tonioprz/tfg/README.md

# tfg

Trabajo de fin de grado realizado por Antonio Pérez García
