tonioprz/tfg/Documentación/Pinout IRC5C.txt

Pin Nombre
1-8 INPUTS
14-21 OUTPUTS

24  GND 
25  VCC-24V
