tonioprz/tfg/Memoria/0c-notacion/notacion.tex

\chapter*{\notationname}
\pagestyle{especial}
\chaptermark{\notationname}
\phantomsection
\addcontentsline{toc}{listasf}{\notationname}
%\section*{Notación}
%\begin{table}[htbp]
\begin{longtable}{p{3cm}p{8.5cm}}

%$\displaystyle D$ & Tasa de símbolos  (sim/s) \\
%$\displaystyle R_b$ & Tasa binaria (bit/s) \\
%$\displaystyle T$ & Tiempo de símbolo (s) \\
%$\displaystyle T_{b}$ & Tiempo de bit (s) \\
%$W\left( {t} \right)$ & Ruido blanco\\
%$w\left( {t} \right)$ & Función muestra de un ruido blanco\\
%$\displaystyle h_{c}\left( {t} \right)$ & Respuesta impulsiva de un canal LTI continuo en el tiempo\\
%$\displaystyle H_{c}\left( {\omega} \right)$ & Respuesta en frecuencia de un canal LTI continuo en el tiempo\\
%$\displaystyle h_{c}\left( {\tau;t} \right)$ & Respuesta impulsiva de un canal LTV continuo en el tiempo\\
%$\displaystyle H_{c}\left( {\omega;t} \right)$ & Respuesta en frecuencia de un canal LTV continuo en el tiempo\\
%$\displaystyle h_{c}\left( {n} \right)$ & Respuesta impulsiva de un canal LTI discreto en el tiempo\\
%$\displaystyle H_{c}\left( {\Omega} \right)$ & Respuesta en frecuencia de un canal LTI discreto en el tiempo\\
ABB & Asea Brown Boveri \\
CAD & Computer-Aided Design \\
CC & Corriente Continua \\
E/S & Entrada/Salida \\
EEPROM & Electrically Erasable Programmable Read-Only Memory\\
ETSI & Escuela Técnica Superior de Ingeniería \\
g & Gramo \\
GND & Tierra \\
GPIO & General-Purpouse Input/Output. Pines de uso general \\
I2C & Inter-Integrated Circuit \\
ICSP & In-circuit Serial Programming \\
IP & Internet Protocol \\
kB & Kilobyte \\
k$\Omega$ & Kiloohmio \\
LCD & Liquid-Crystal Display. Pantalla de cristal líquido \\
LED & Light-Emitting Diode \\
mA & Miliamperio \\
MHz & Megahercios \\
mm & Milímetros \\
PWM & Modulación por ancho de pulso \\
SPI & Serial Peripheral Interface \\
SRAM & Static Random-Access Memory \\
TCP & Transmission Control Protocol \\
TTL & Transistor-Transistor Logic\\
TWI & Two-Wire Interface \\
UART & Universal Asynchronous Receiver-Transmitter \\
USB & Universal Serial Bus \\
V & Voltio \\

\end{longtable}
\newpage
%\end{table}
%

%\phantomsection
%\addcontentsline{toc}{listasf}{Acrónimos}
%\section*{Acrónimos}
%\begin{table}[htbp]
%\begin{tabular}{p{2cm}p{10cm}}
%Escuela Técnica Superior de In
%LTI & Lineal Invariante con el Tiempo \\
%LTV& Lineal Variable con el Tiempo\\
%AWGN& Ruido blanco gaussiano aditivo\\
%DMS& Fuente discreta sin memoria\\
%AEP& Propiedad de equipartición asintótica\\
%WLLN& Ley Débil de los Grandes Números\\
%DMC& Canal Discreto sin Memoria\\
%BSC& Canal Simétrico Binario\\
%BEC& Canal Binario con Borrado\\
%\end{tabular}
%\end{table}

%\nota{El libro de Lapidoth tiene una excelente recopilación.}
