tonioprz/tfg/Memoria/0a-agradecimientos/agradecimientos.tex

% !TEX root =../LibroTipoETSI.tex
\chapter*{Agradecimientos}
%\pagestyle{especial}
\pagestyle{empty}
%\chaptermark{Agradecimientos}
\phantomsection
%\addcontentsline{toc}{listasf}{Agradecimientos}
%\vspace{1cm}
%{\huge{Agradecimientos}}
%\vspace{1cm}

\lettrine[lraise=-0.1, lines=2, loversize=0.25]{E}{l} trabajo de fin de grado
es la culminación de mucho esfuerzo realizado durante años de mis padres Antonio
y Rosario. Agradezco su paciencia y apoyo durante todo este tiempo.

{\flushleft{\hfill \emph{Antonio Pérez García}}}%
\vspace{-.3cm}
%{\flushleft{\hfill \emph{Subdirección de Comunicaciones y Recursos Comunes}}}%
{\flushleft{\hfill \emph{Sevilla, 2022}}}%
