tonioprz/tfg/Memoria/10-anexos/anexo.tex

\chapter*{Anexo II: Esquemáticos de placas electrónicas}
\pagestyle{especial}
\chaptermark{Anexo II: Esquemáticos de placas electrónicas}
\phantomsection
\addcontentsline{toc}{listasf}{Anexo II: Esquemáticos de placas electrónicas}

En este anexo se adjuntan los planos esquemáticos de las placas electrónicas
