tonioprz/tfg/Memoria/09-guiadeuso/HMI_REAL.pdf

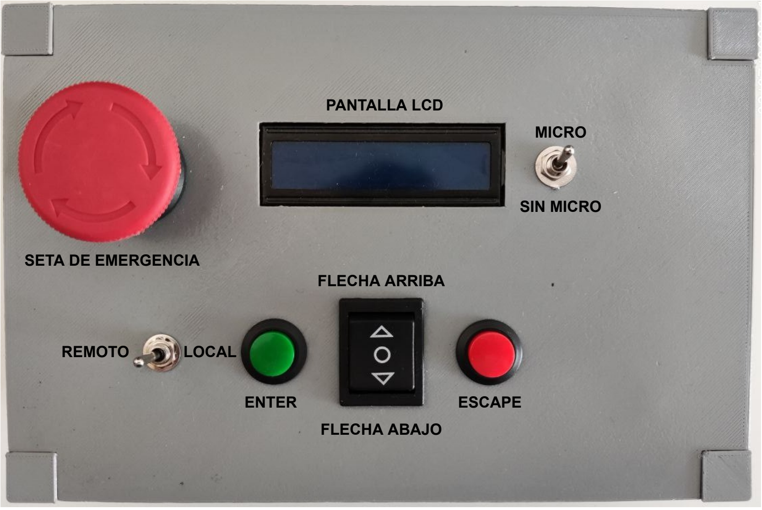
[picture p31: page 1]

MICRO

SIN MICRO

REMOTO | LOCAL
ENTER | ESCAPE
FLECHA ABAJO

FLECHA ARRIBA

PANTALLA LCD

SETA DE EMERGENCIA
