tonioprz/tfg/Documentación/HMI.jpg

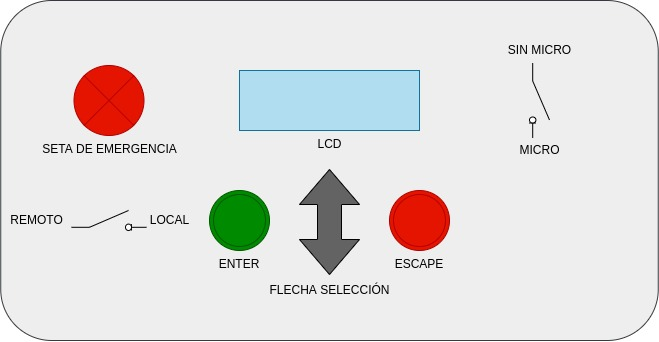
Documentación/HMI.jpg
