tonioprz/tfg/Documentación/Meme.jpg

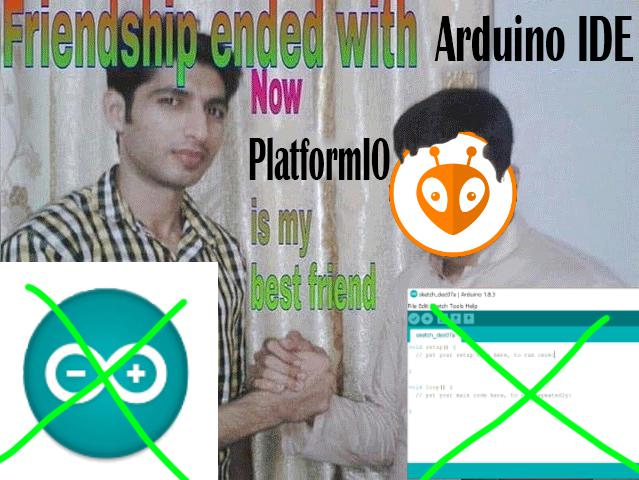
Documentación/Meme.jpg
