tonioprz/tfg/Documentación/output/salida.pdf_dir/0_salida.pdf.jpg

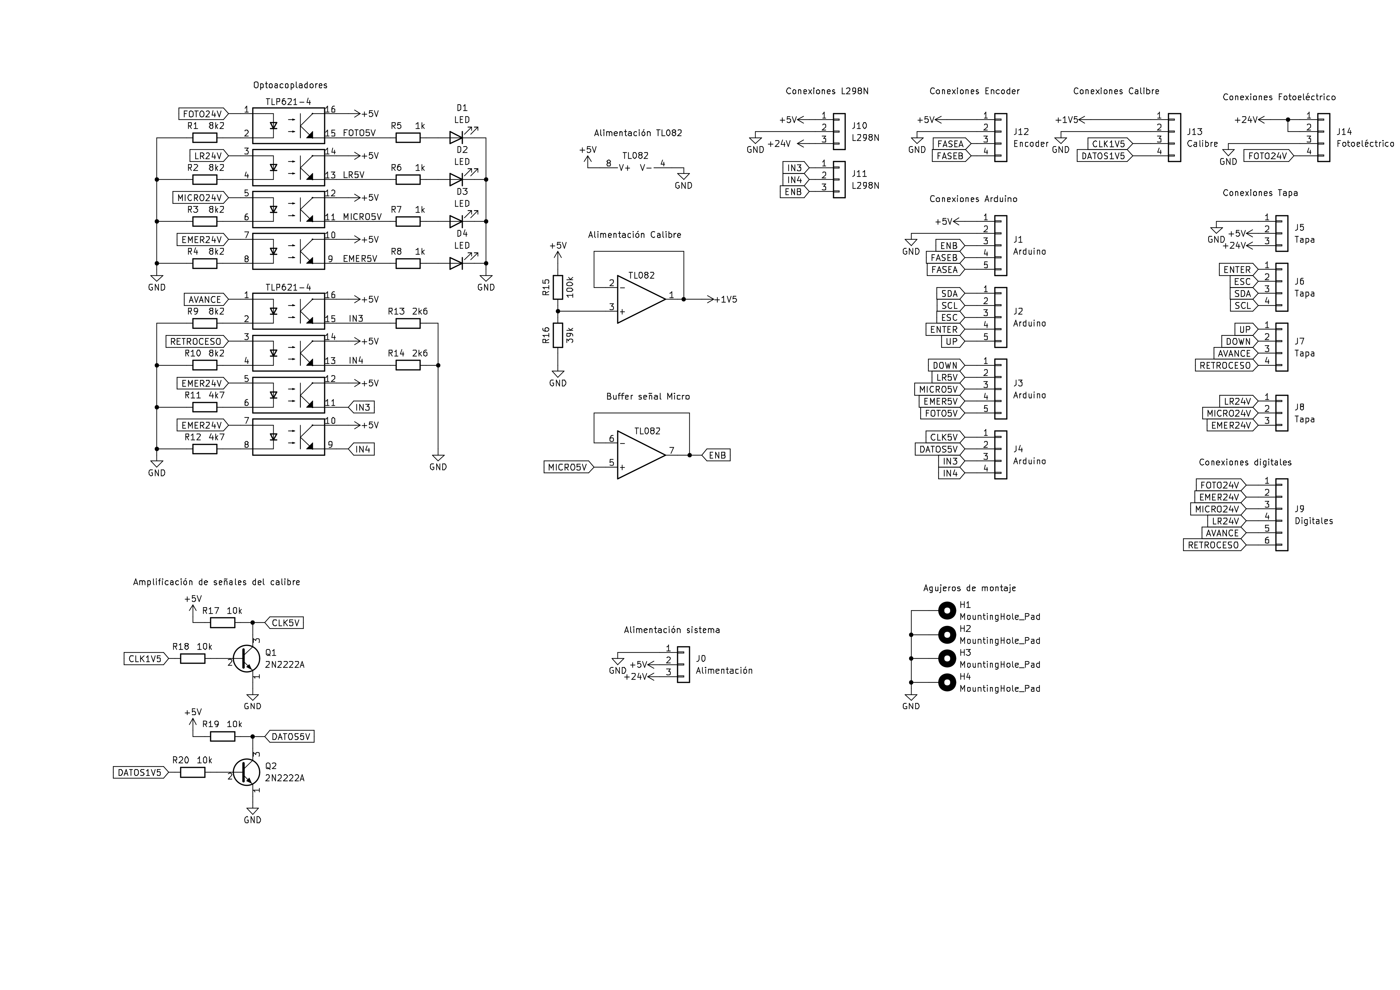
Documentación/output/salida.pdf_dir/0_salida.pdf.jpg
