tonioprz/tfg/Documentación/planotapa.jpg

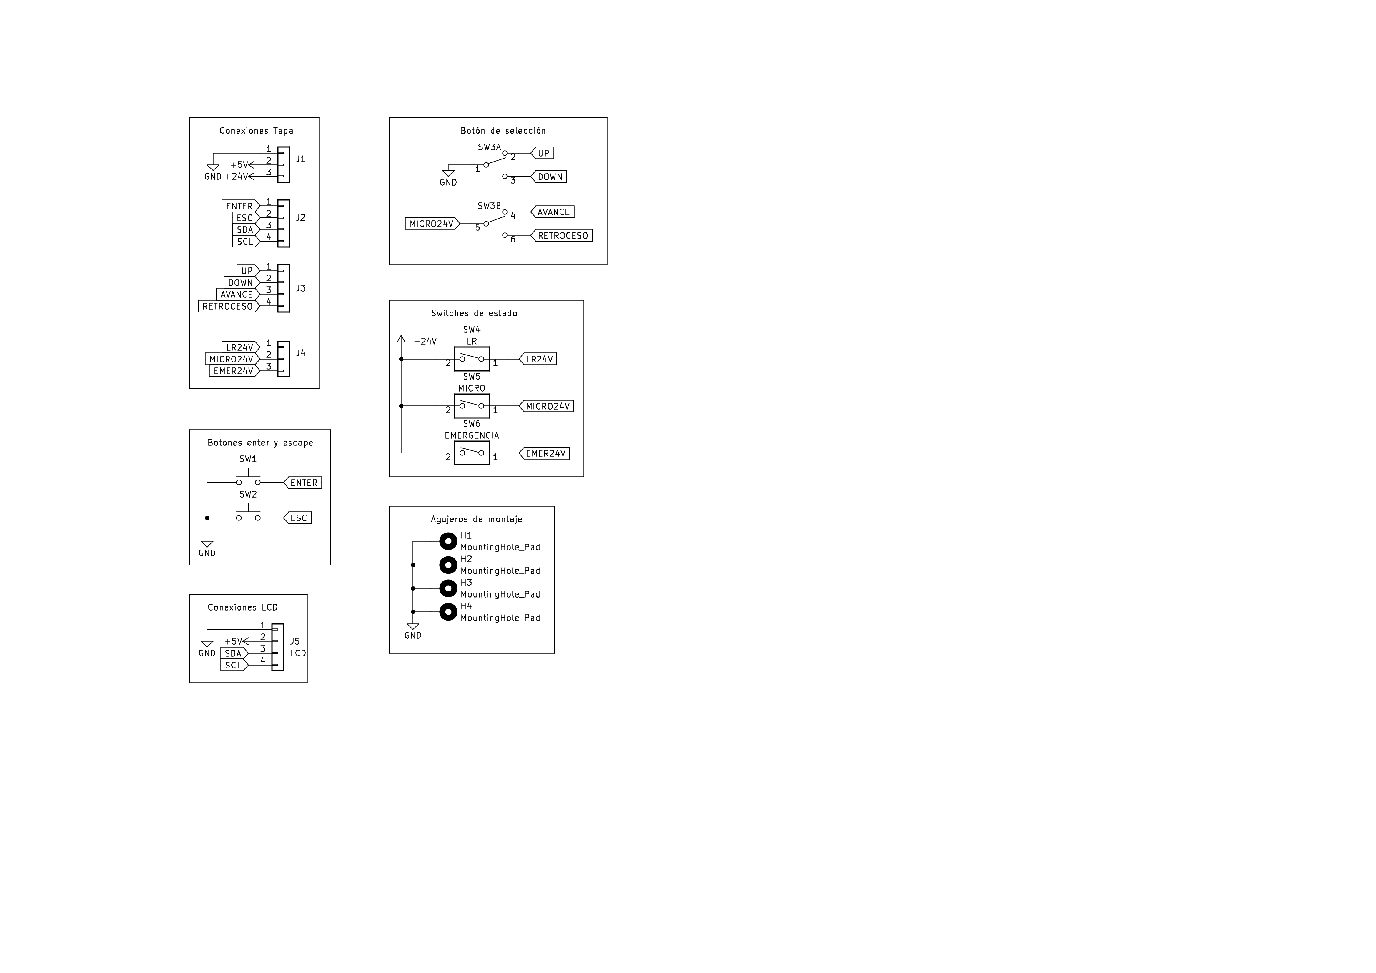
Documentación/planotapa.jpg
