tonioprz/tfg/Memoria/02-hardware/11-optoac.png

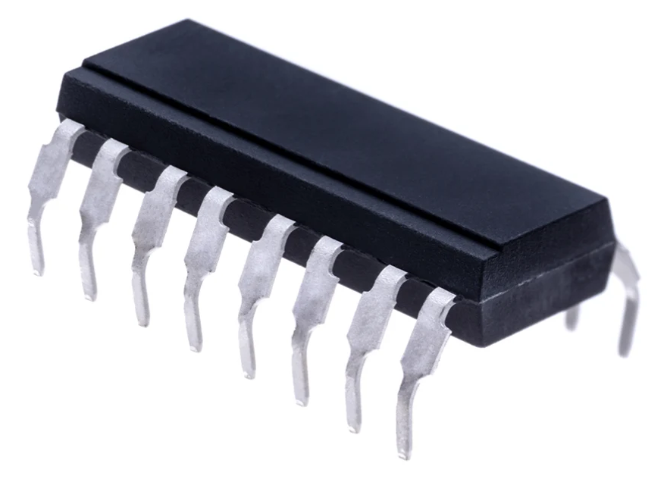
Memoria/02-hardware/11-optoac.png
