tonioprz/tfg/Memoria/09-guiadeuso/paneldecontrol.jpg

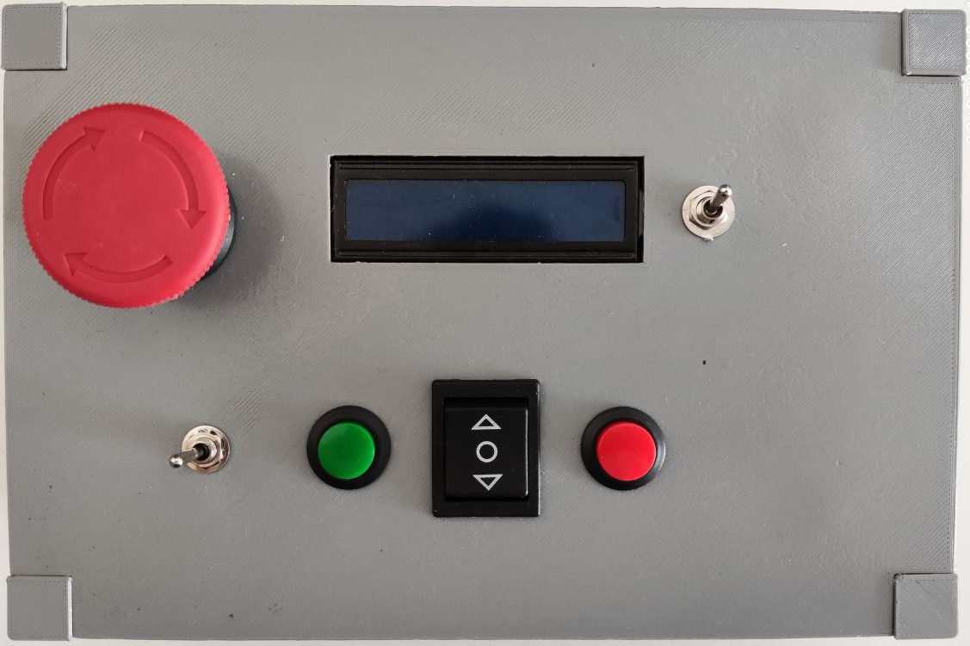
Memoria/09-guiadeuso/paneldecontrol.jpg
