tonioprz/tfg/Memoria/09-guiadeuso/wobj1.png

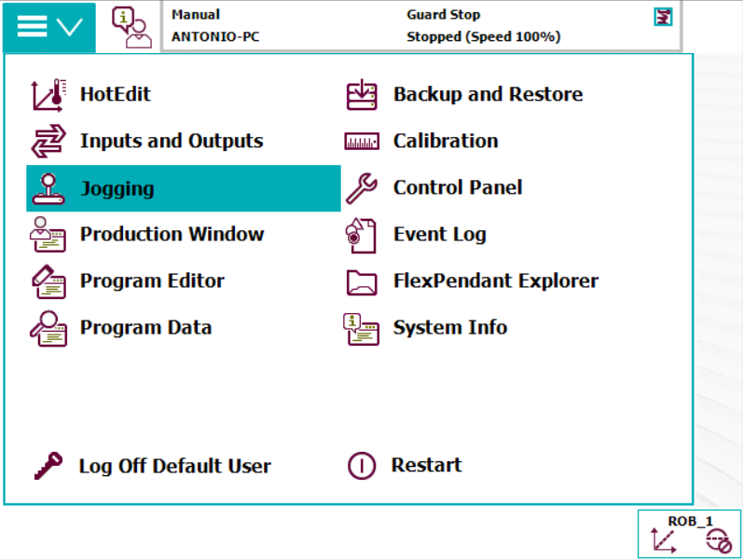
Memoria/09-guiadeuso/wobj1.png
