tonioprz/tfg/Memoria/09-guiadeuso/wobj2.png

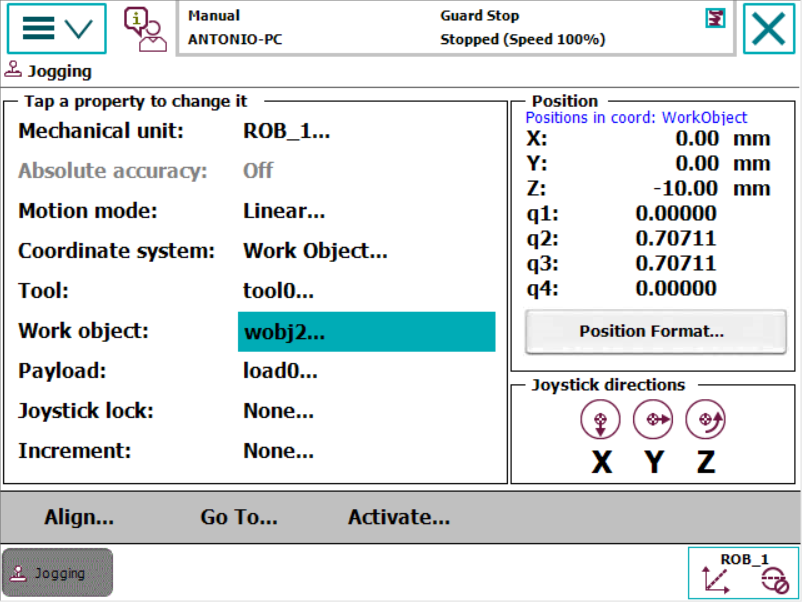
Memoria/09-guiadeuso/wobj2.png
