tonioprz/tfg/Memoria/09-guiadeuso/wobj3.png

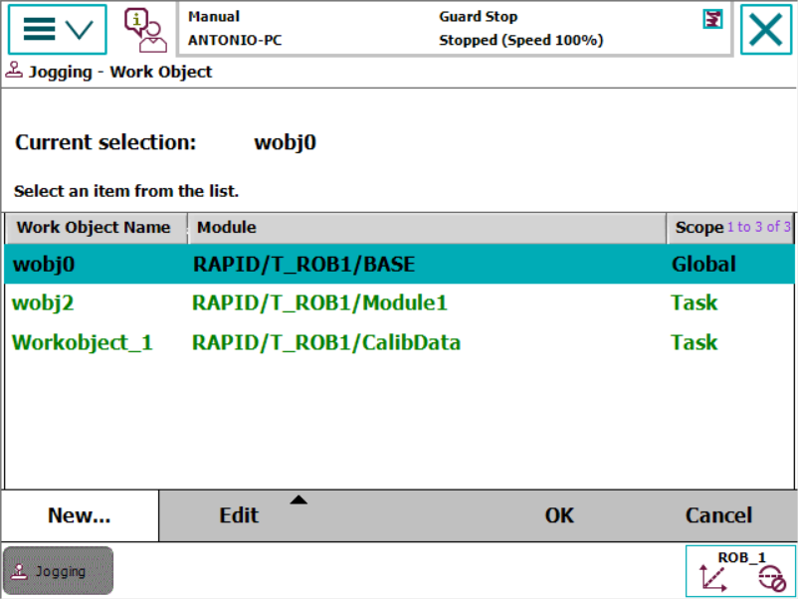
Memoria/09-guiadeuso/wobj3.png
