tonioprz/tfg/Memoria/04-caja/ensamblajetapaplanta.png

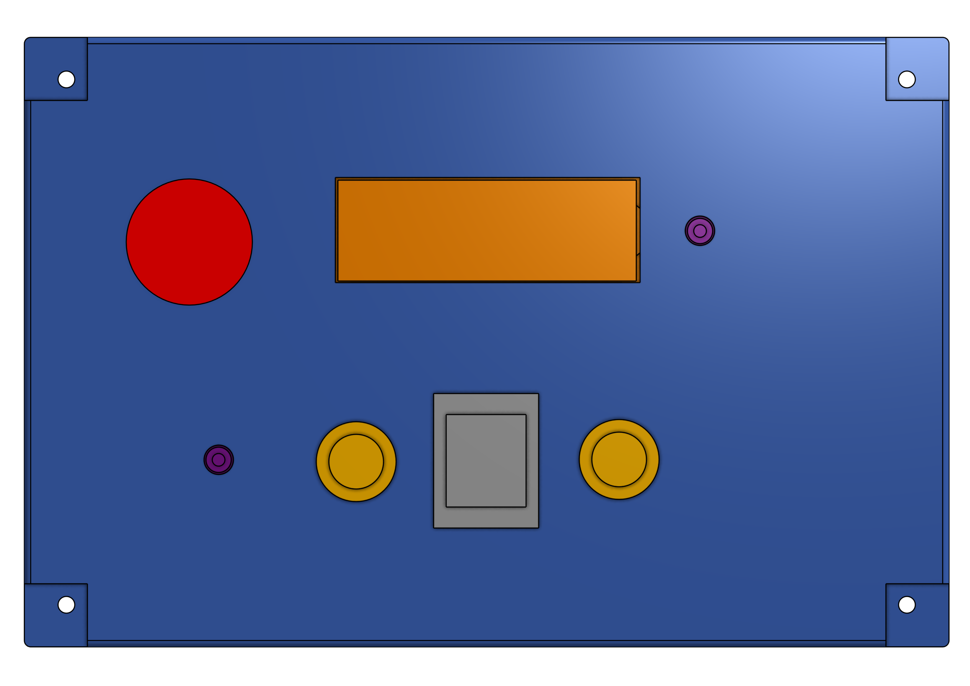
Memoria/04-caja/ensamblajetapaplanta.png
