tonioprz/tfg/Memoria/07-resultados/modoemer.jpg

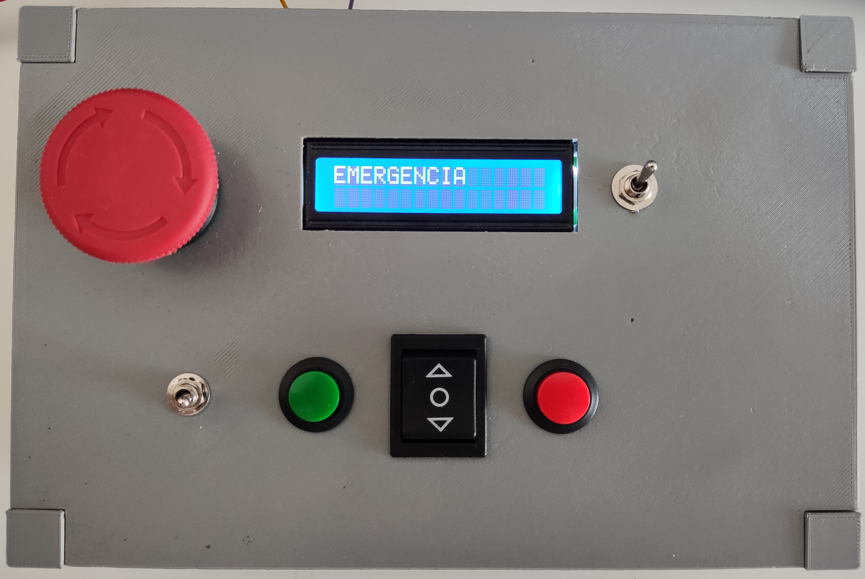
Memoria/07-resultados/modoemer.jpg
