tonioprz/tfg/Memoria/07-resultados/modolocal.jpg

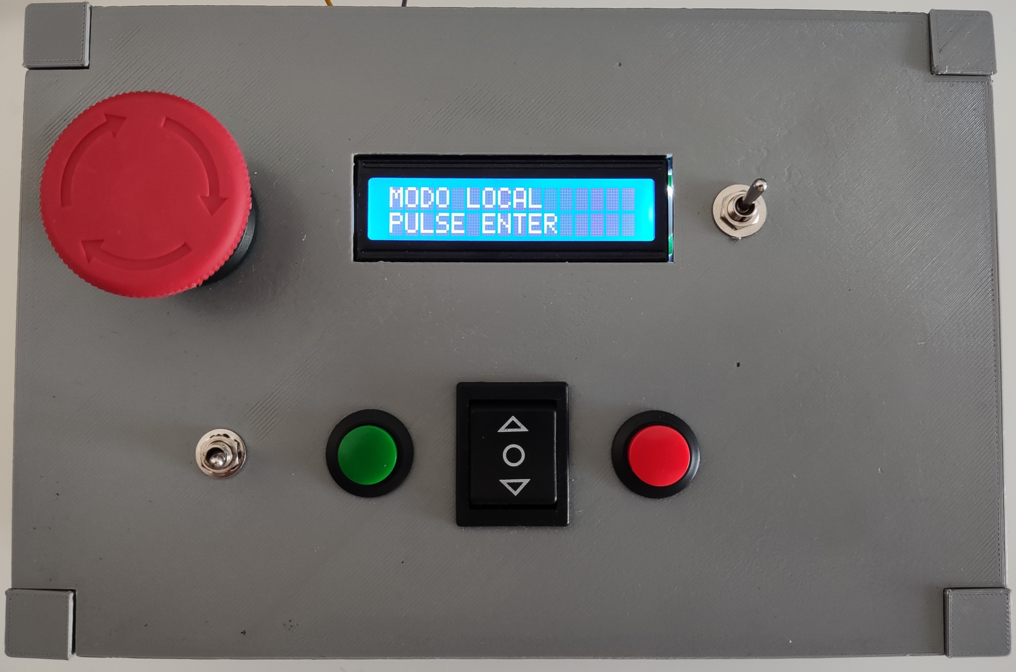
Memoria/07-resultados/modolocal.jpg
