tonioprz/tfg/Memoria/07-resultados/modoremoto.jpg

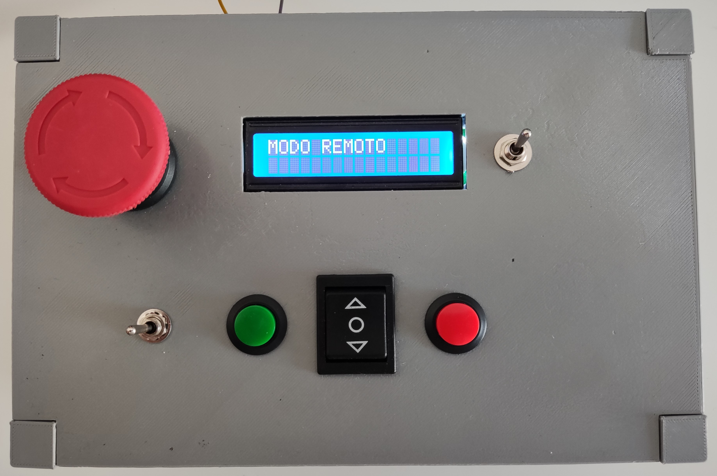
Memoria/07-resultados/modoremoto.jpg
