tonioprz/tfg/Memoria/07-resultados/modosinmicro.jpg

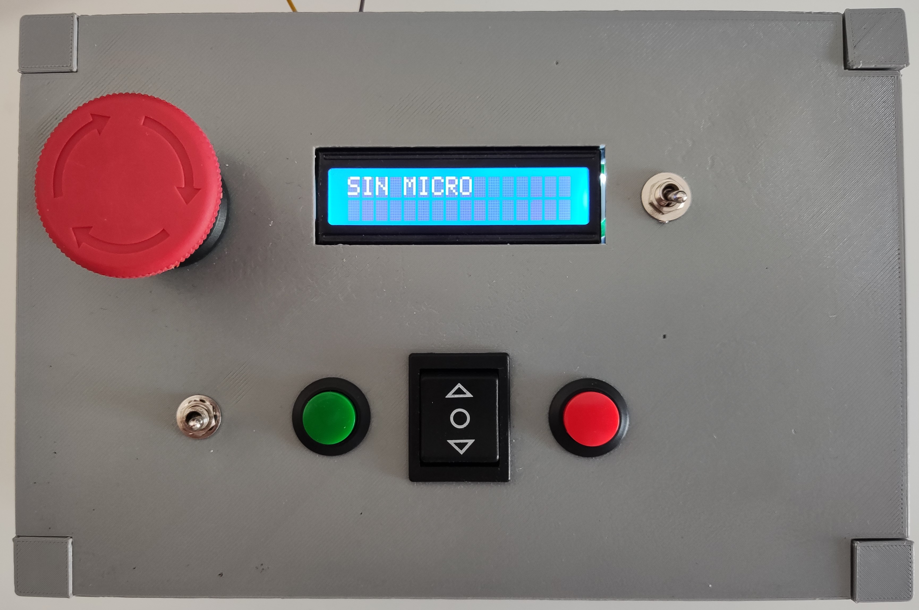
Memoria/07-resultados/modosinmicro.jpg
