tonioprz/tfg/Documentación/CAJA1.pdf

Modos de funcionamiento:

1 | 2 | 3
LOCAL | CON MICRO | CONFIGURACION | AVANCE POS. ABSOLUTA

AVANCE DISCRETO

EJECUCION | AVANCE POS. ABSOLUTA
| AVANCE DISCRETO
SIN MICRO | | Avance/retroceso con pulsador
REMOTO | CON MICRO | CONFIGURACION | AVANCE POS. ABSOLUTA

AVANCE DISCRETO

EJECUCION | AVANCE POS. ABSOLUTA
| AVANCE DISCRETO
SIN MICRO | Avance/retroceso señales digitales de 24V
CON MICRO | ETHERNET: PosX, PosY Sensor fotoeléctrico Estados de cinta Actuación remota | ETHERNET: PosX, PosY Sensor fotoeléctrico Estados de cinta Actuación local
SIN MICRO | Salidas digitales al robot: SD: Sensor fotoeléctrico Actuación remota desde robot ED: Avance cinta ED: Retroceso cinta | Manual sin conexión SD: Sensor fotoeléctrico Actuación local Pulsador avance cinta Pulsador retroceso cinta
REMOTO | LOCAL

LOCAL-CON MICRO:

Actuación local: Ordenes de posicionado por parte del usuario (introducción de datos y pulsar ejecución de movimiento)

El micro lee las posiciones y sensor fotoeléctrico y lo transmite por Ethernet al robot, enviando estados del posicionador (ejecutando orden, fin de orden, emergencia, etc).

LOCAL-SIN MICRO:

Actuación local: movimiento manual del motor de la cinta con los pulsadores de avance/retroceso (usuario)

El micro está fuera de servicio, el robot no comunicado.

El robot solo recibe SEÑALES DIGITALES de sensor fotoeléctrico

REMOTO-CON MICRO:

Actuación remota: Ordenes de posicionado por parte del robot (introducción de datos y ordenes de ejecución de movimientos) a través de Ethernet

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

REMOTO-SIN MICRO:

Actuación remota: movimiento del motor de la cinta con SEÑALES DIGITALES avance/retroceso por parte del robot.

El robot recibe SEÑALES DIGITALES de sensor fotoeléctrico

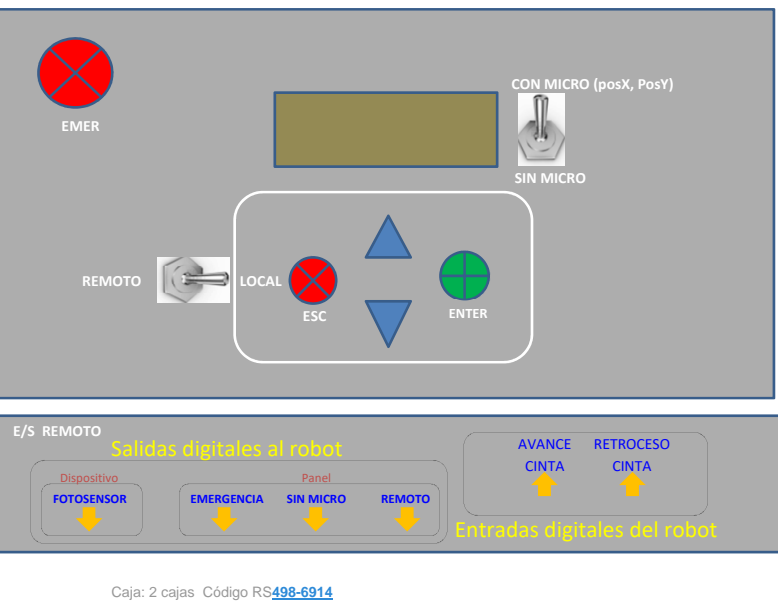
[picture p52: page 3]
ESC; ENTER; FOTOSENSOR; EMERGENCIA; EMER; SIN MICRO; AVANCE CINTA; LOCAL; E/S REMOTO; REMOTO; RETROCESO CINTA; Dispositivo; Panel

CON MICRO (posX, PosY)

Salidas digitales al robot

Entradas digitales del robot

Caja: 2 cajas Código RS498-6914

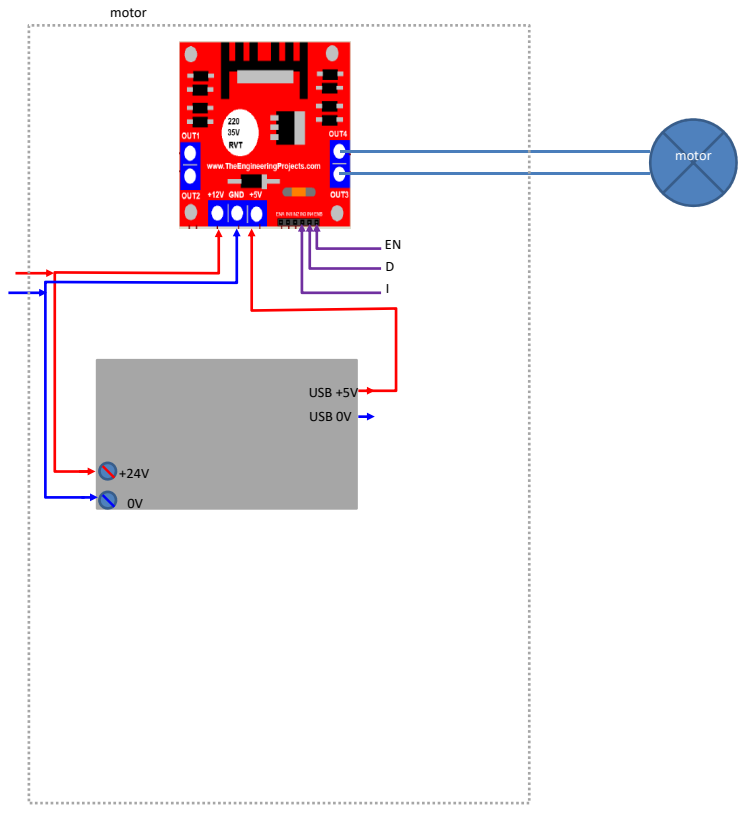
[picture p53: page 4]
motor; USB +5V; USB 0V

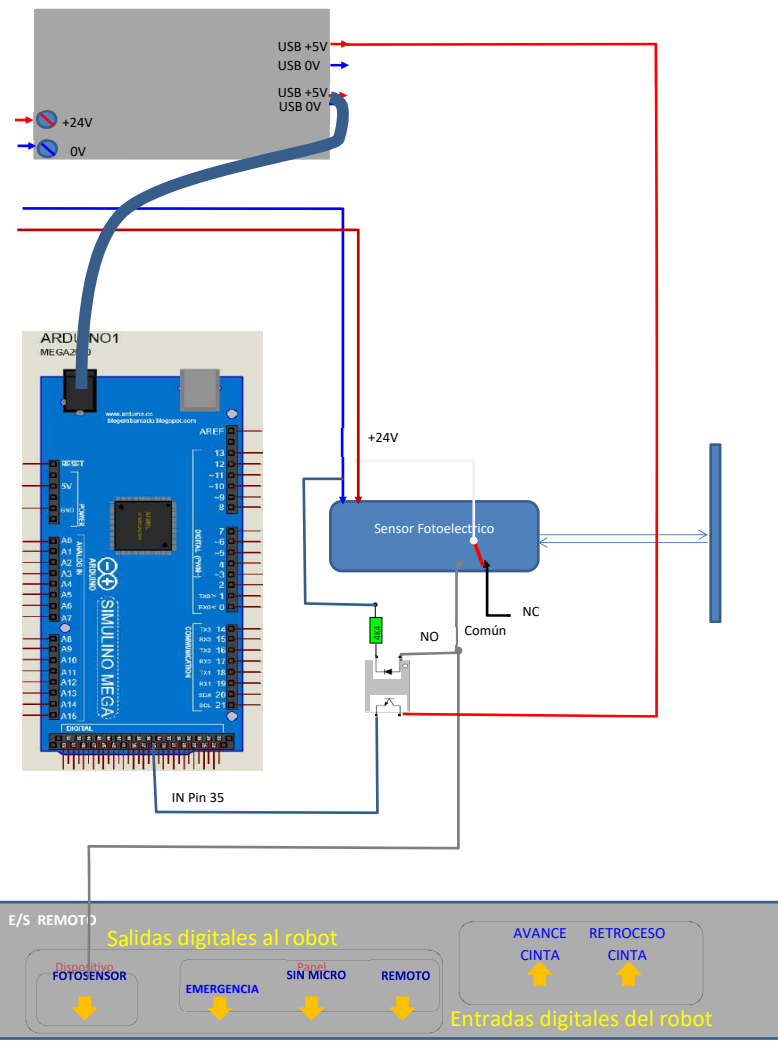
[picture p54: page 5]
Sensor Fotoelectrico; Común; FOTOSENSOR; SIN MICRO; REMOTO; EMERGENCIA; AVANCE CINTA; E/S REMOTO; RETROCESO CINTA; Dispositivo; Panel; USB +5V USB 0V; IN Pin 35

Salidas digitales al robot

Entradas digitales del robot

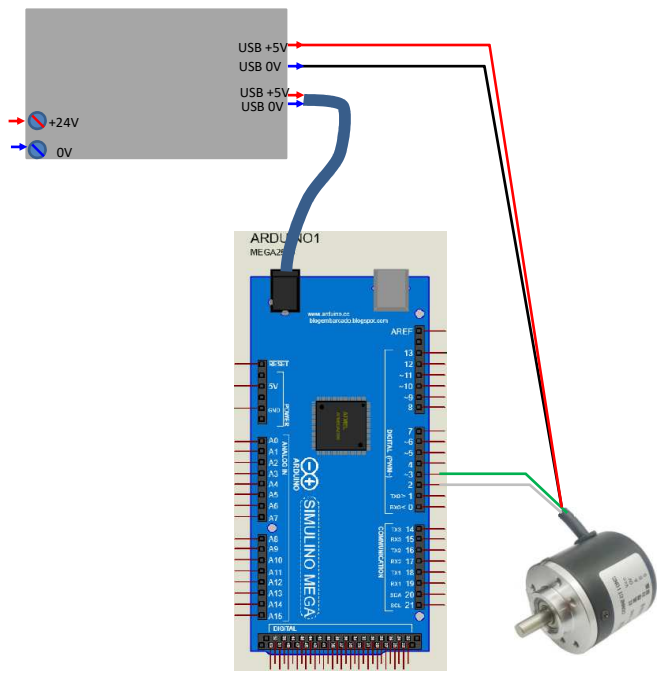
[picture p55: page 6]
USB; USB 0

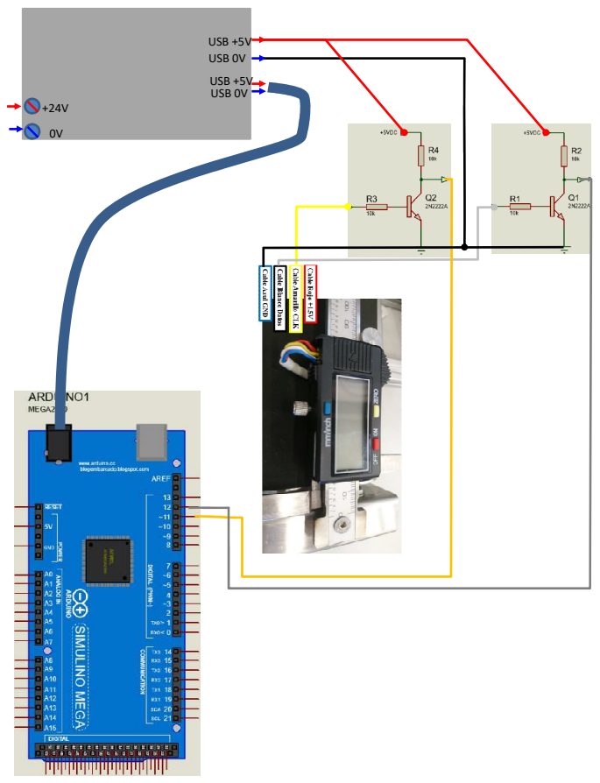
[picture p56: page 7]
USB; USB 0

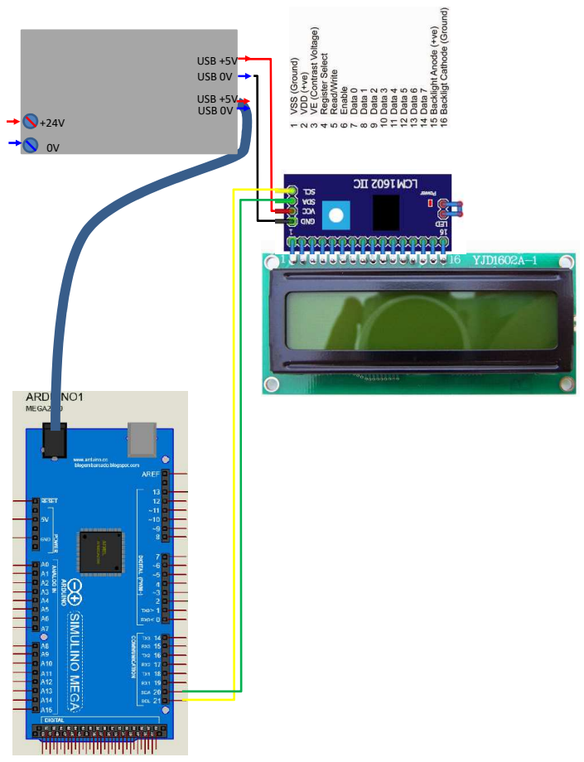
[picture p57: page 8]
USB; USB 0

## Salidas digitales al robot

## Entradas digitales del robot

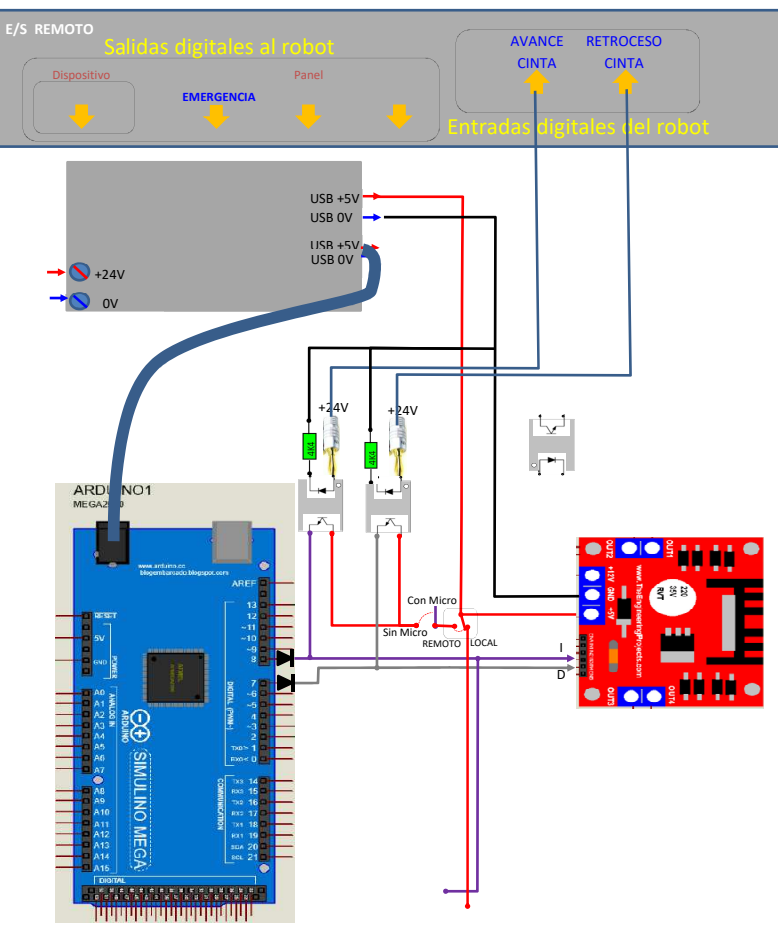
[picture p58: page 9]
EMERGENCIA; AVANCE CINTA; E/S REMOTO; RETROCESO CINTA; Dispositivo; Panel; USB +5V USB 0V; REMOTO LOCAL; Con Micro; Sin Micro
