tonioprz/tfg/Memoria/09-guiadeuso/DIGITALES_REAL.pdf

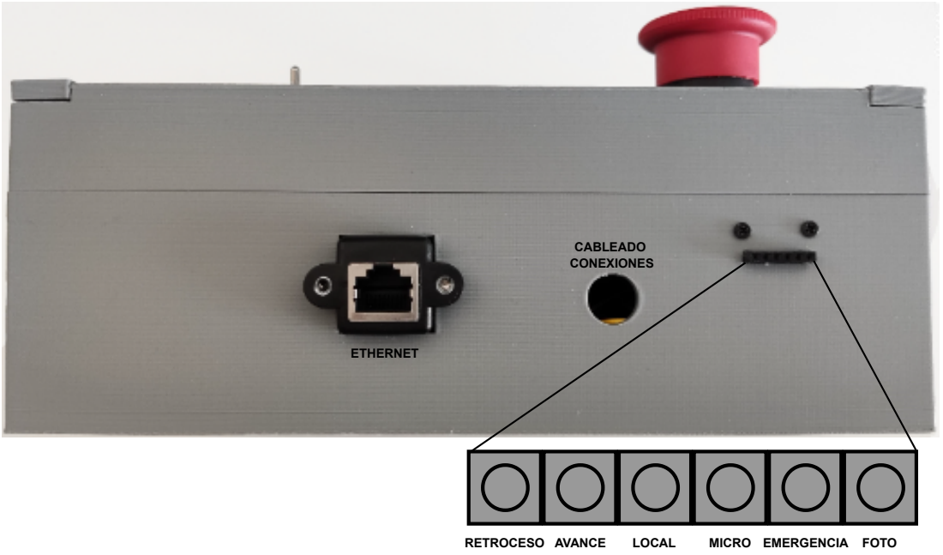
[picture p59: page 1]
RETROCESO AVANCE; LOCAL; MICRO EMERGENCIA FOTO; ETHERNET; CABLEADO CONEXIONES
