tonioprz/tfg/Memoria/planos/tapa.pdf

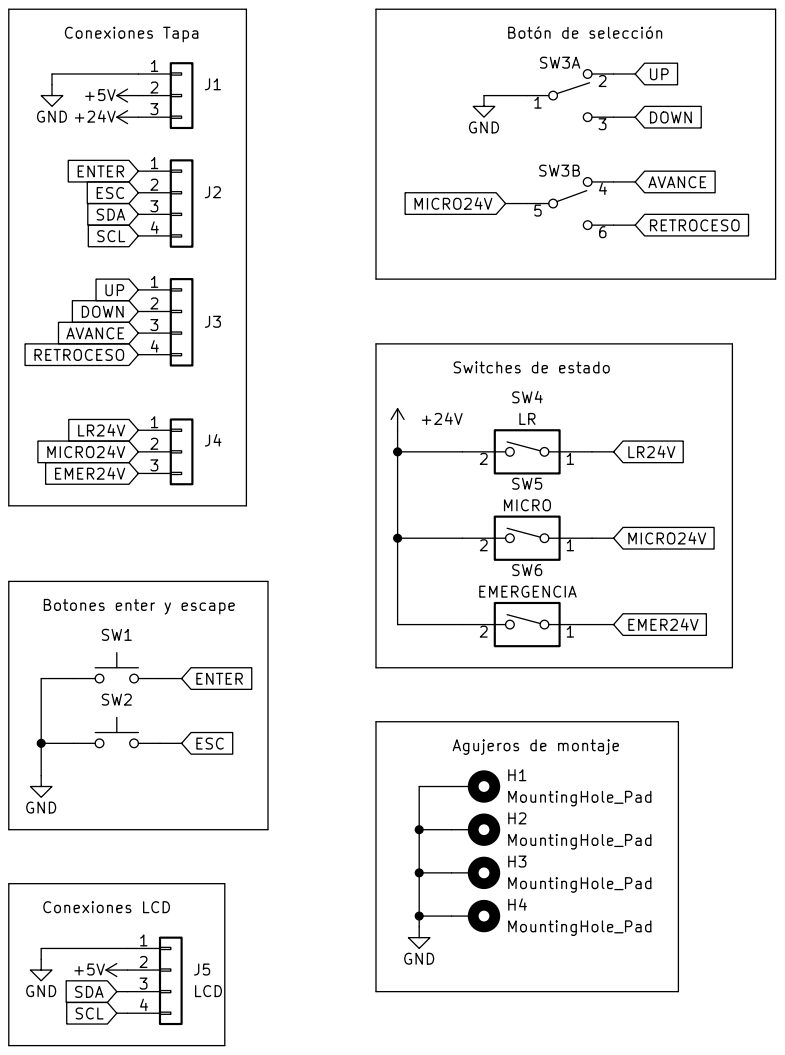
[picture p60: page 1]

EMER24V DOWN
Agujeros de montaje Switches de estado
