tonioprz/tfg/Documentación/salida.pdf

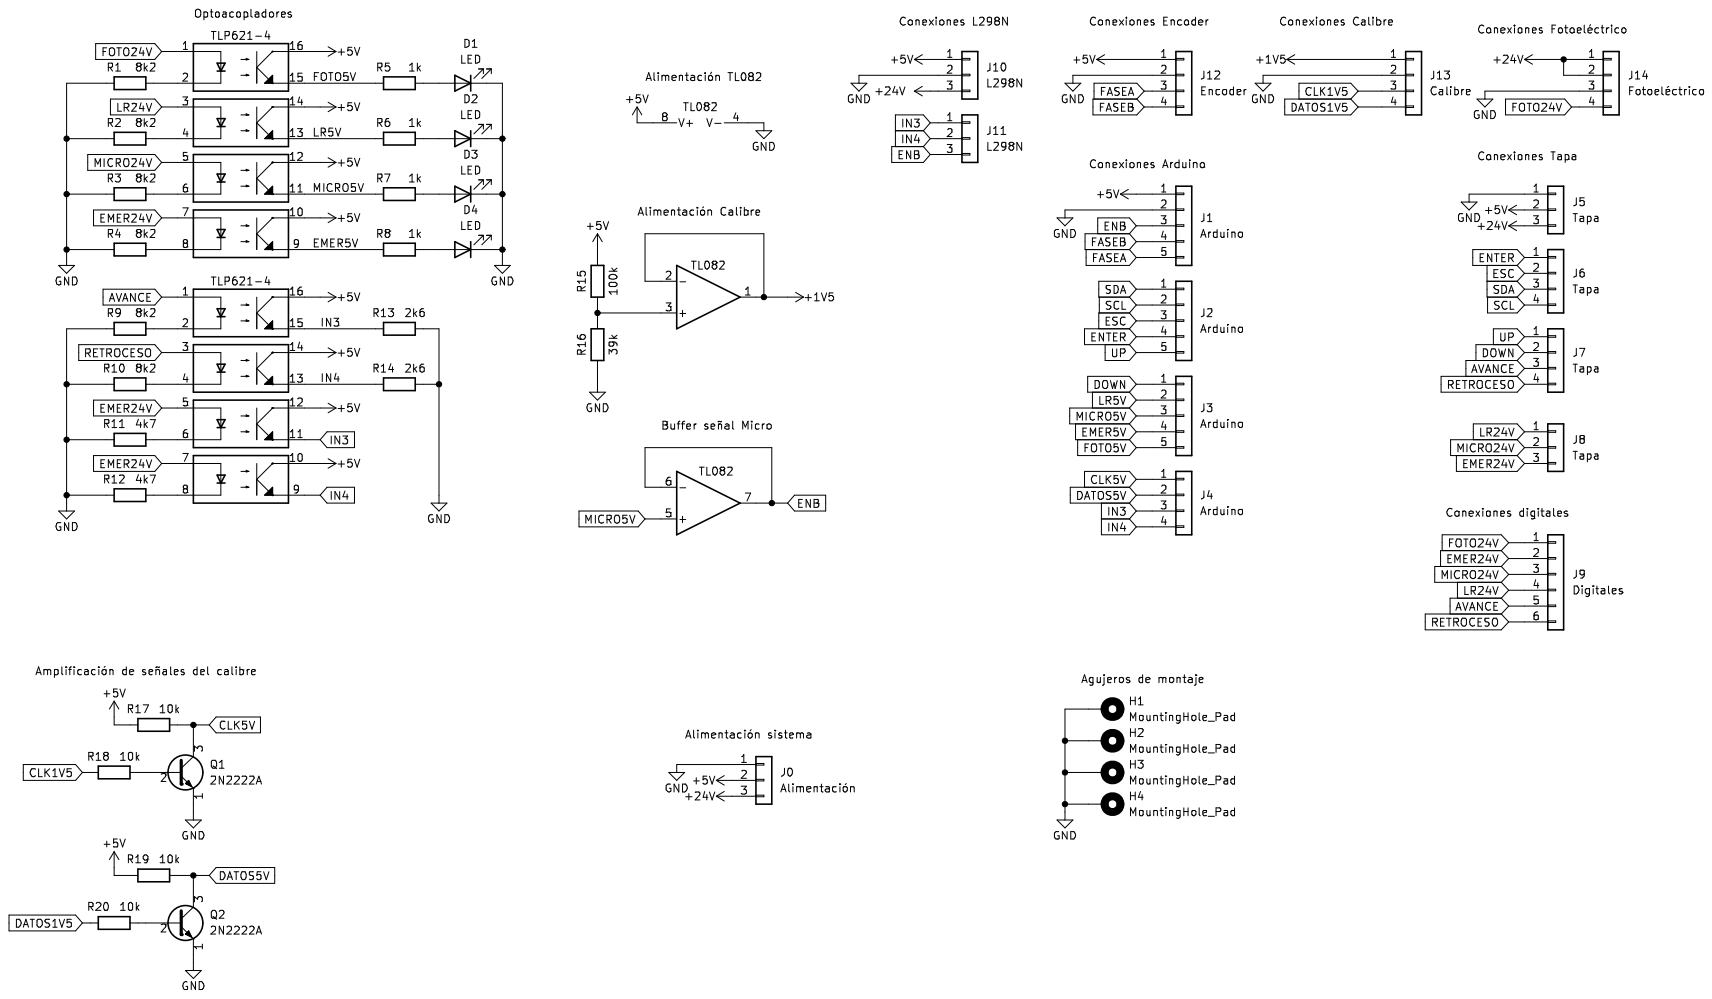
[picture p61: page 1]
