tonioprz/tfg/Memoria/03-placa/base.pdf

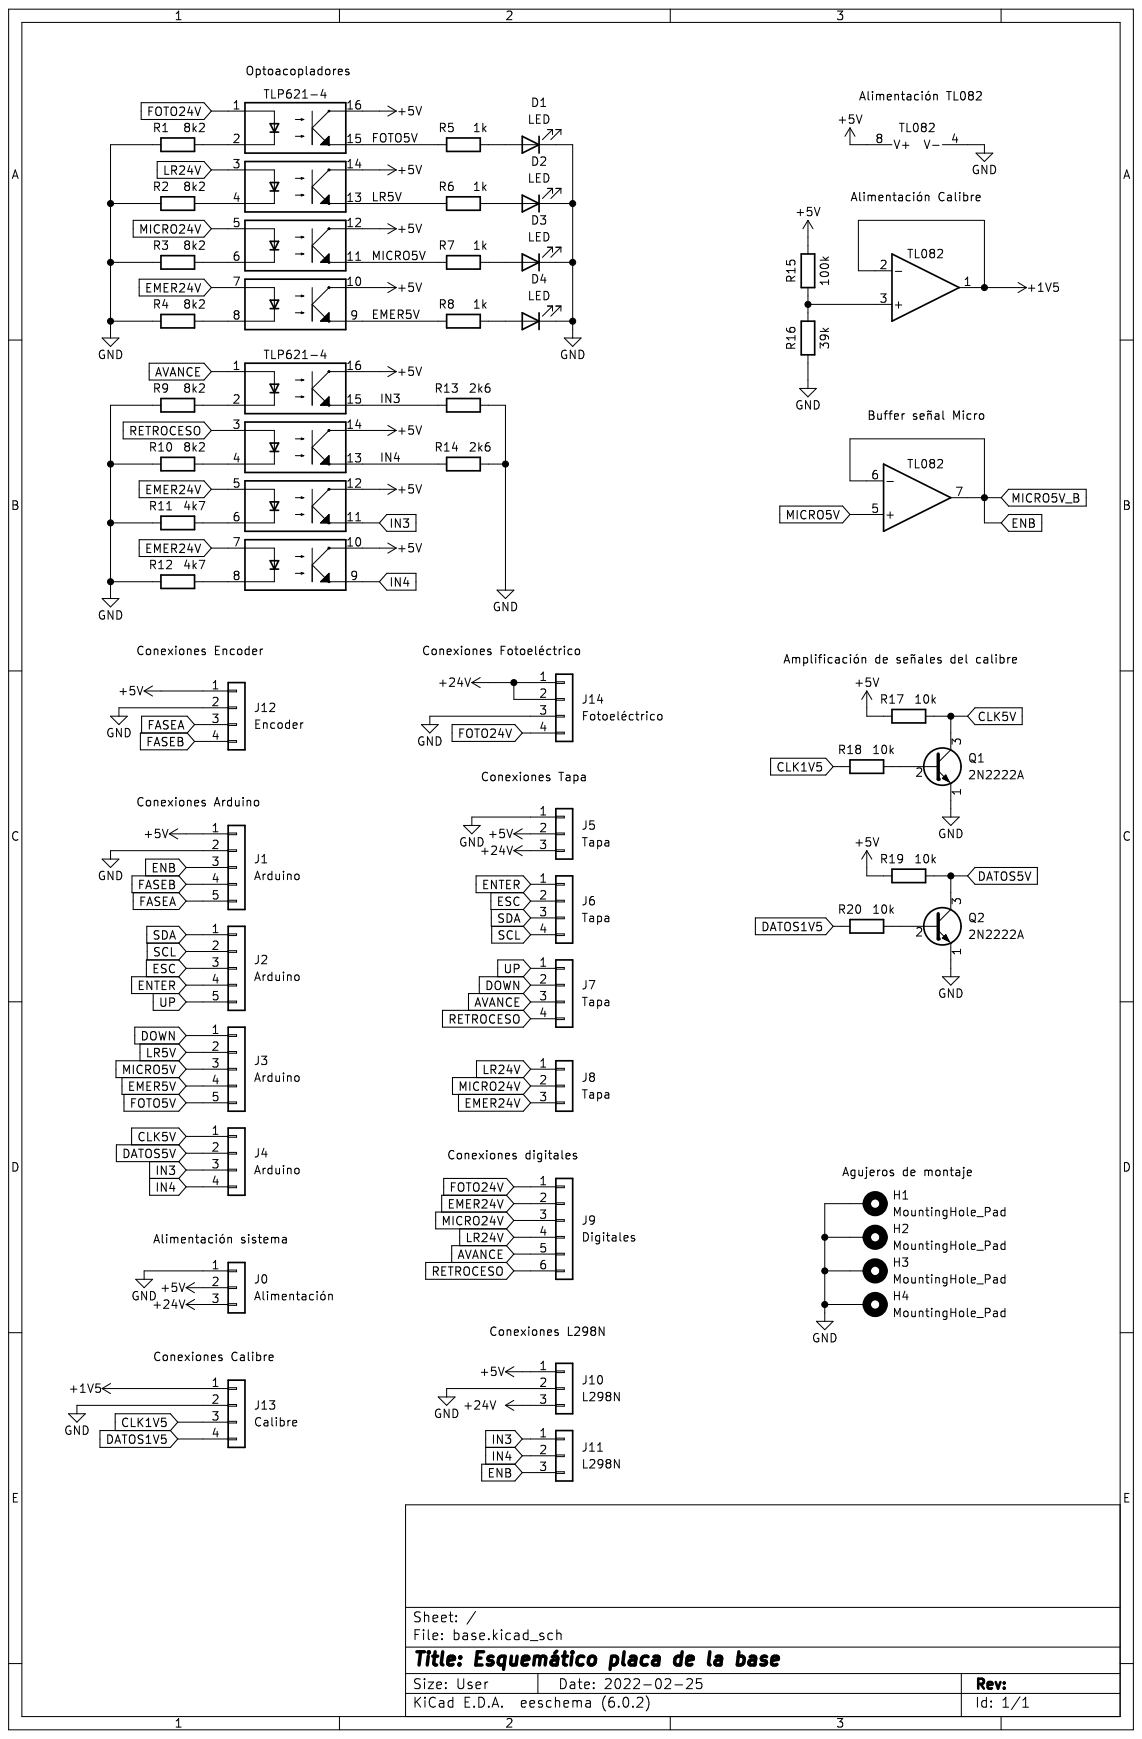
[picture p62: page 1]
