tonioprz/tfg/Memoria/03-placa/tapa.pdf

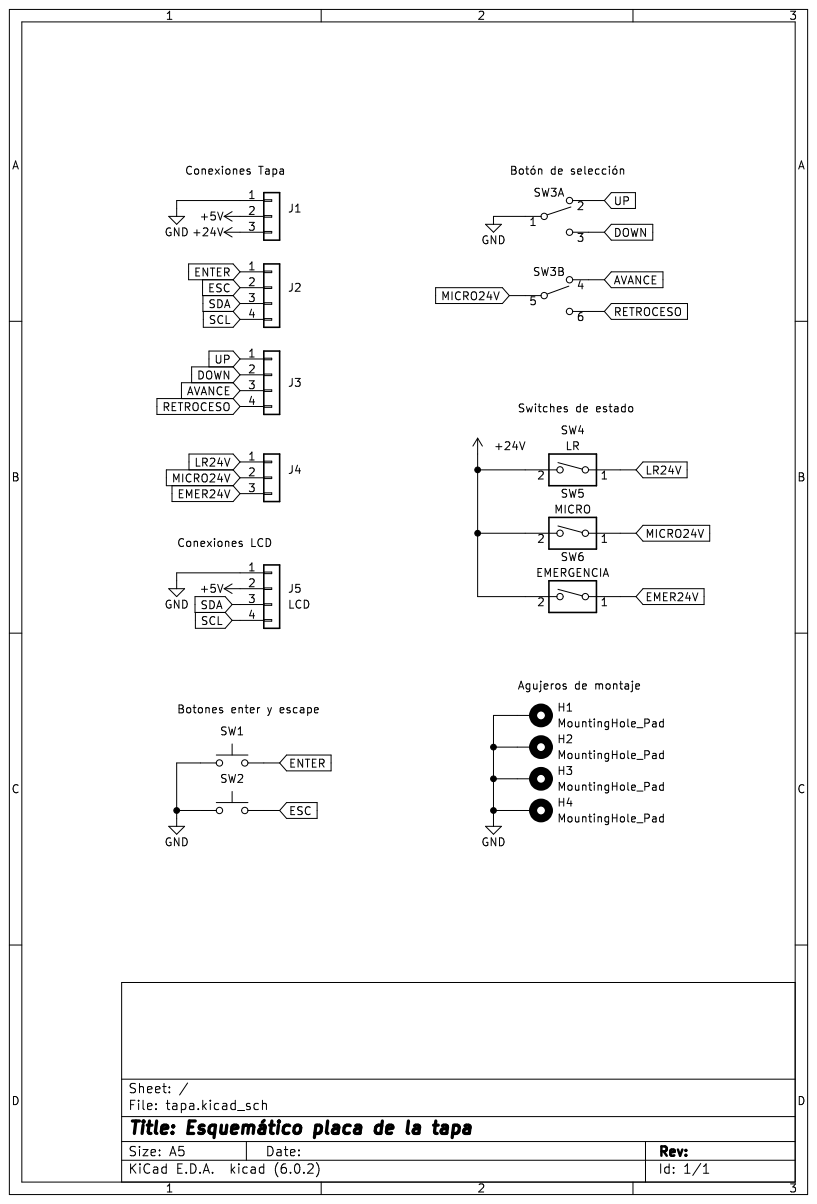
[picture p63: page 1]
