tonioprz/tfg/Memoria/10-anexos/base.pdf

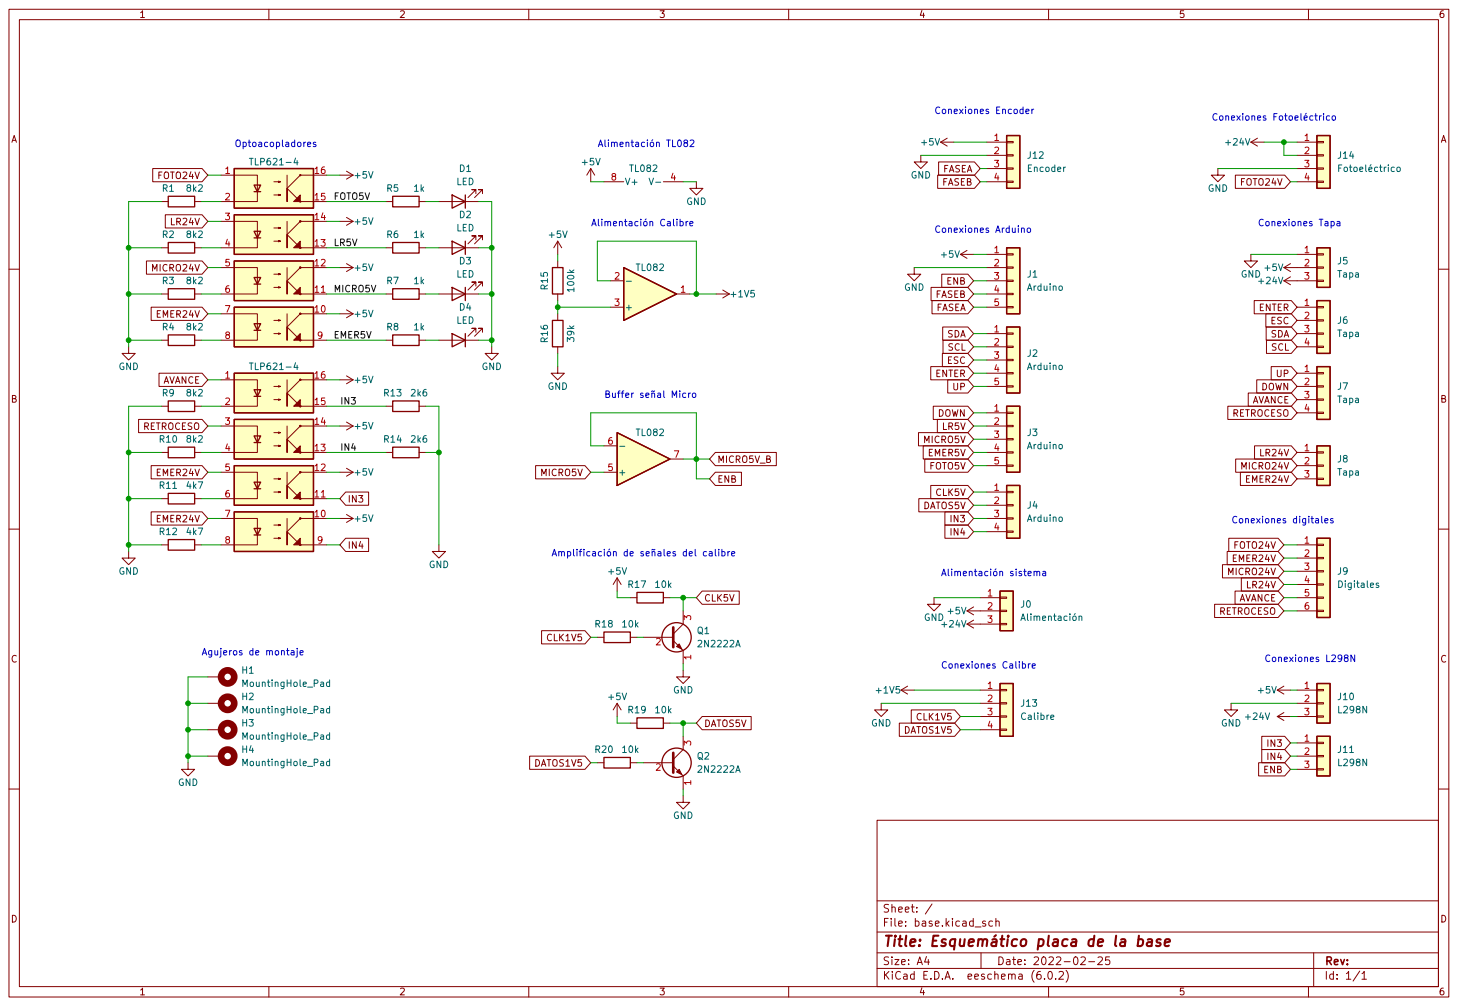
[picture p64: page 1]
