tonioprz/tfg/Memoria/01-introduccion/HMI.pdf

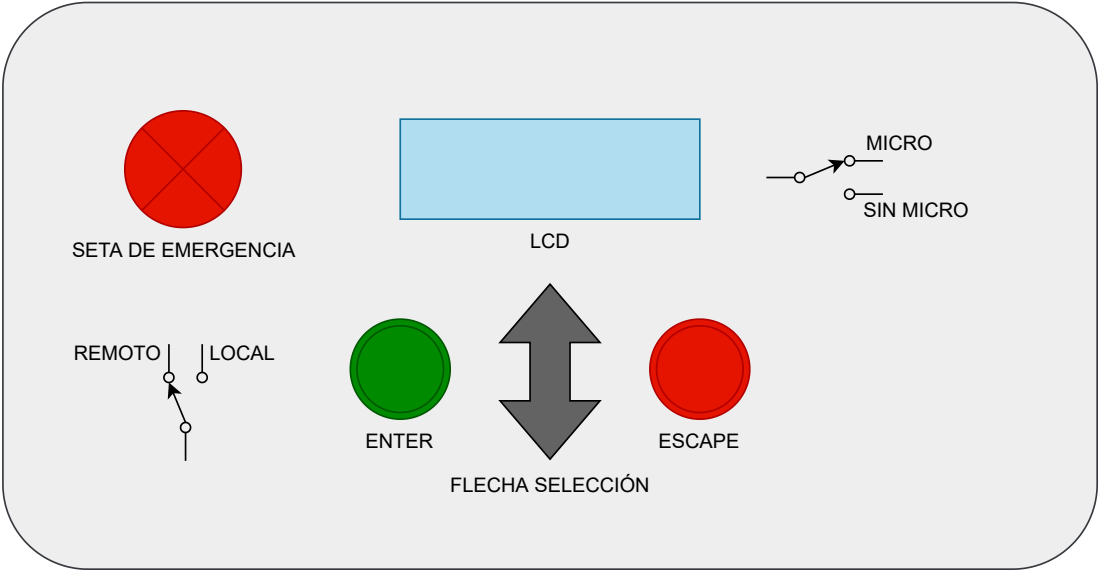
[picture p65: page 1]
SETA DE EMERGENCIA; LCD; ENTER; ESCAPE; REMOTO; LOCAL; FLECHA SELECCIÓN; MICRO; SIN MICRO
