tonioprz/tfg/Memoria/05-arduino/diagramaflujo.pdf

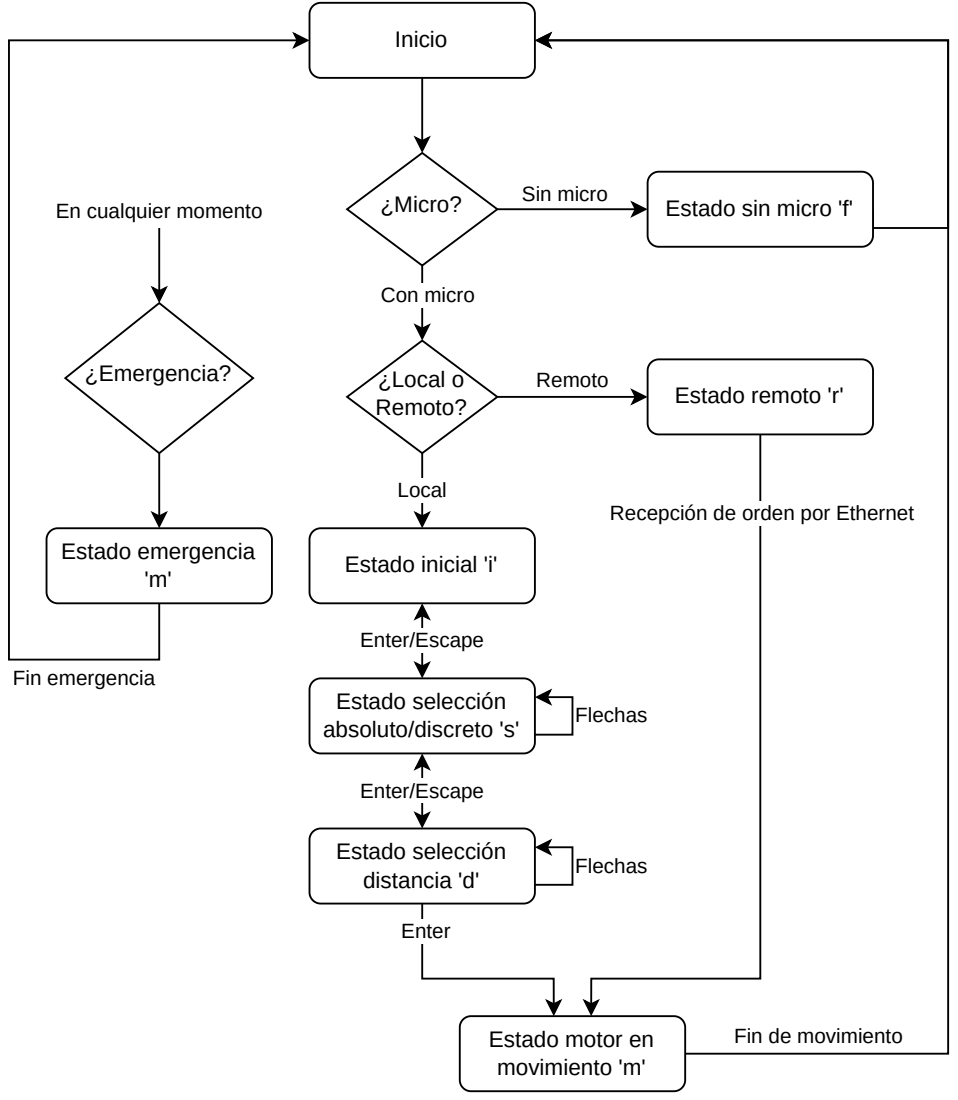
[picture p66: page 1]
Estado inicial 'i'; Enter/Escape; Inicio; Con micro; Remoto; Local; ¿Local o Remoto?; Estado remoto 'r'; Enter; Estado selección distancia 'd'; Estado motor en; Fin de movimiento; movimiento 'm'; Flechas; ¿Emergencia?; Fin emergencia; Estado emergencia 'm'

Sin micro ¿Micro?

Estado sin micro 'f'

En cualquier momento

Recepción de orden por Ethernet

Flechas Estado selección
absoluto/discreto 's'
