tonioprz/tfg/Memoria/01-introduccion/DIGITALES.pdf

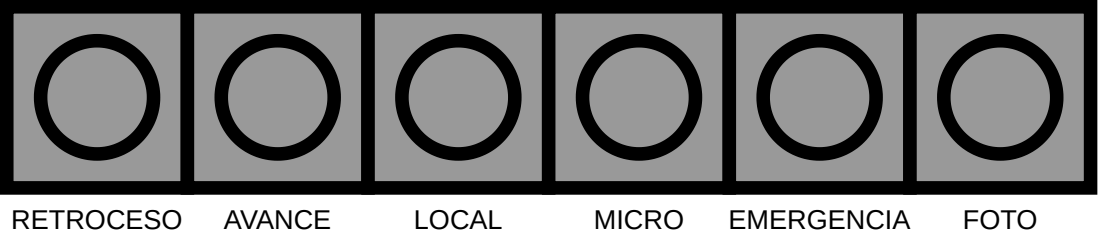
[picture p67: page 1]
RETROCESO; AVANCE; LOCAL; MICRO; EMERGENCIA; FOTO
