tonioprz/tfg/Memoria/03-placa/fondo.pdf

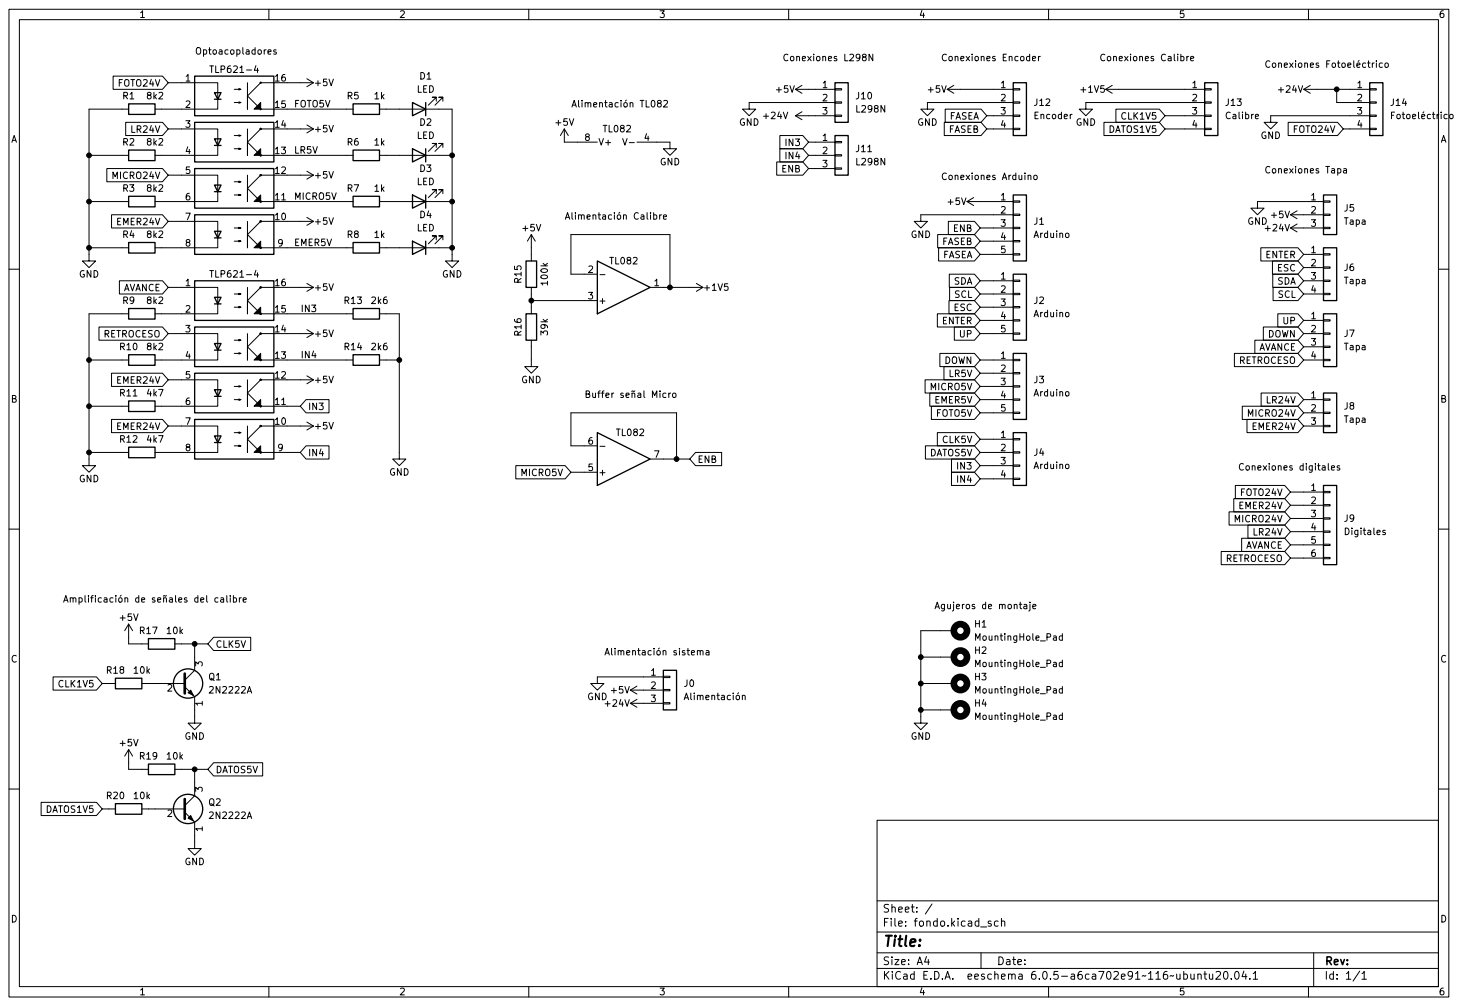
[picture p68: page 1]
