tonioprz/tfg/Memoria/planos/fondo.pdf

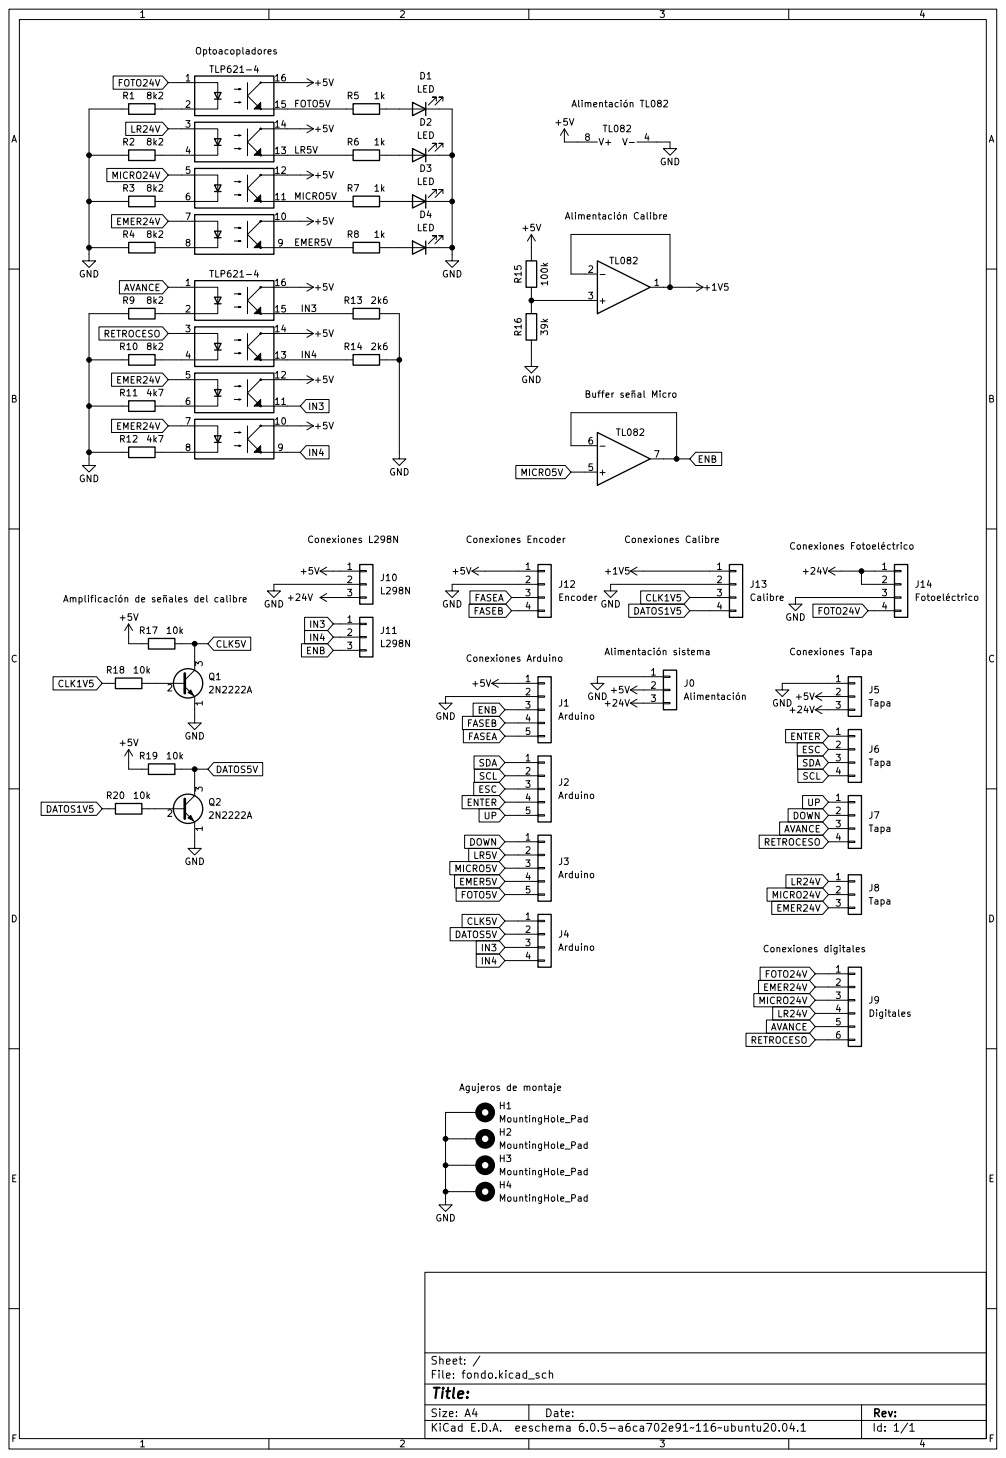
[picture p69: page 1]
