tonioprz/tfg/Placa/fondo/home/antonio/fondo.pdf

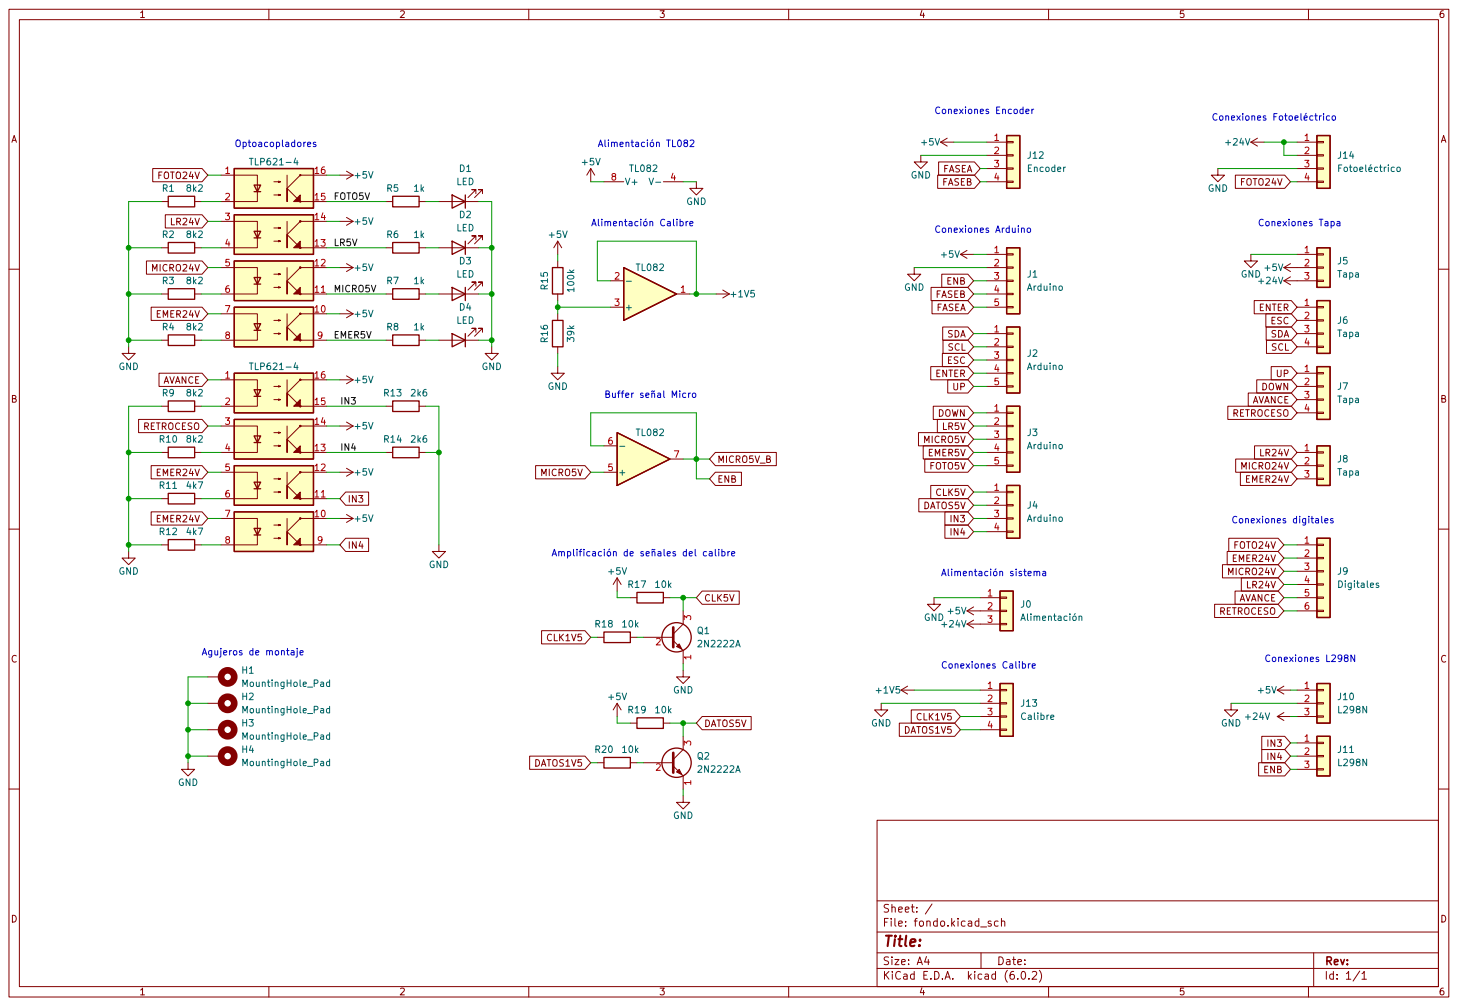
[picture p70: page 1]
