tonioprz/tfg/(list of files, drawings)

Other design files:
Placa/fondo/fondo.dsn
