tonioprz/tfg/Placa/fondo/fondo.kicad_pcb

## KiCad design Placa/fondo/fondo.kicad_pcb (2022-02-23)

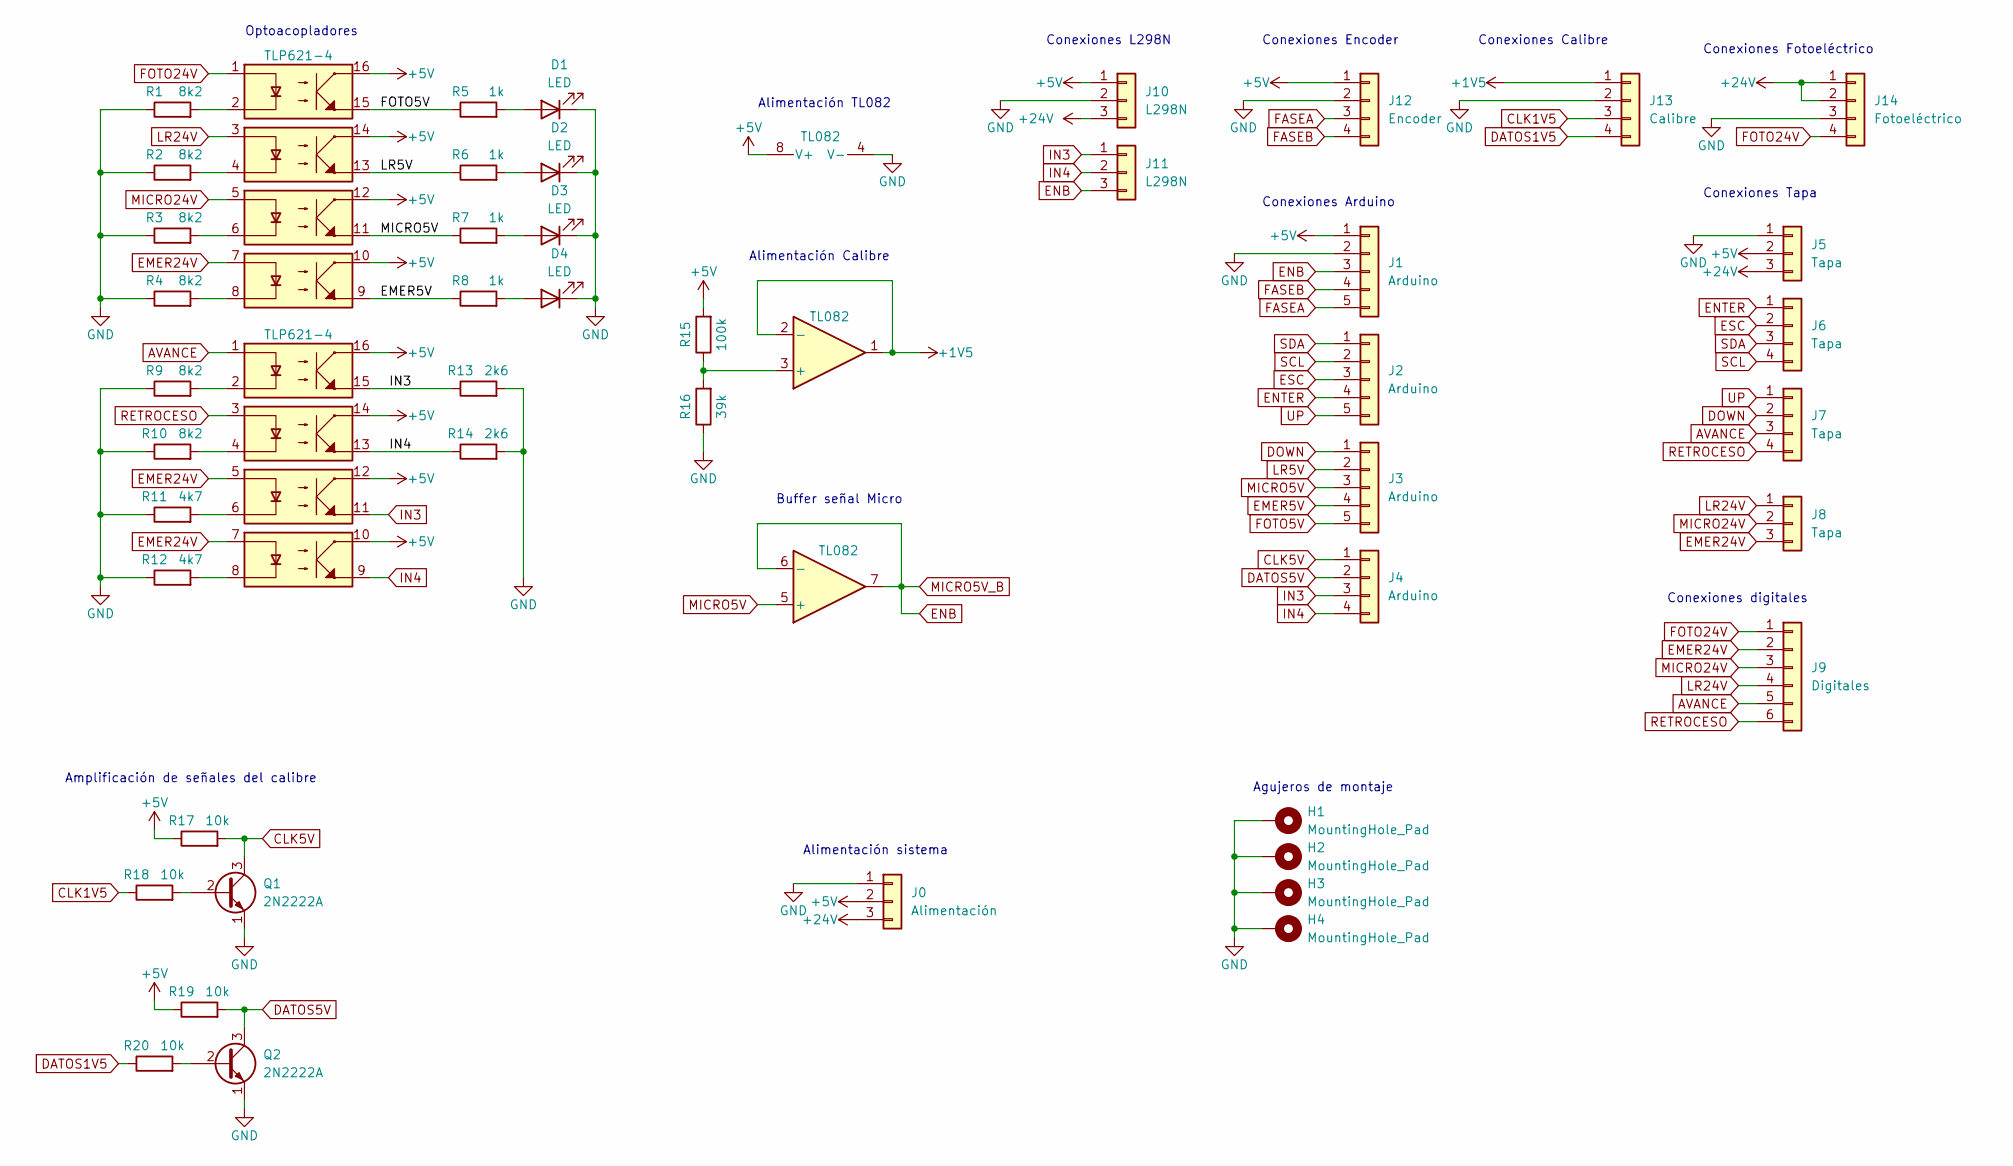
[picture p71: schematic fondo.kicad_sch]

Parts:
D1, D2, D3, D4: LED; LED_D3.0mm
H1, H2, H3, H4: MountingHole_Pad; MountingHole_3.2mm_M3_DIN965_Pad
J0: Alimentación; TerminalBlock_bornier-3_P5.08mm
J1, J2, J3: Arduino; TerminalBlock_TE_282834-5_1x05_P2.54mm_Horizontal
J4: Arduino; TerminalBlock_TE_282834-4_1x04_P2.54mm_Horizontal
J5, J8: Tapa; TerminalBlock_TE_282834-3_1x03_P2.54mm_Horizontal
J6, J7: Tapa; TerminalBlock_TE_282834-4_1x04_P2.54mm_Horizontal
J9: Digitales; TerminalBlock_TE_282834-6_1x06_P2.54mm_Horizontal
J10: L298N; TerminalBlock_bornier-3_P5.08mm
J11: L298N; TerminalBlock_TE_282834-3_1x03_P2.54mm_Horizontal
J12: Encoder; TerminalBlock_TE_282834-4_1x04_P2.54mm_Horizontal
J13: Calibre; TerminalBlock_TE_282834-4_1x04_P2.54mm_Horizontal
J14: Fotoeléctrico; TerminalBlock_TE_282834-4_1x04_P2.54mm_Horizontal
Q1, Q2: 2N2222A; TO-92
R1, R2, R3, R4, R9, R10: 8k2; R_Axial_DIN0207_L6.3mm_D2.5mm_P10.16mm_Horizontal
R5, R6, R7, R8: 1k; R_Axial_DIN0207_L6.3mm_D2.5mm_P10.16mm_Horizontal
R11, R12: 4k7; R_Axial_DIN0207_L6.3mm_D2.5mm_P10.16mm_Horizontal
R13, R14: 2k6; R_Axial_DIN0207_L6.3mm_D2.5mm_P10.16mm_Horizontal
R15: 100k; R_Axial_DIN0207_L6.3mm_D2.5mm_P10.16mm_Horizontal
R16: 39k; R_Axial_DIN0207_L6.3mm_D2.5mm_P10.16mm_Horizontal
R17, R18, R19, R20: 10k; R_Axial_DIN0207_L6.3mm_D2.5mm_P10.16mm_Horizontal
U1, U2: TLP621-4; DIP-16_W10.16mm
U3: TL082; DIP-8_W7.62mm

Connections:
+1V5: J13.1, U3.1, U3.2 (-)
+5V: J0.2, J1.1, J5.2, J10.1, J12.1, R15.2, R17.1, R19.1, U1.10, U1.12, U1.14, U1.16, U2.10, U2.12, U2.14, U2.16, U3.8 (V+)
+24V: J0.3, J5.3, J10.3, J14.1, J14.2
AVANCE: J7.3, J9.5, U2.1
CLK1V5: J13.3, R18.1
CLK5V: J4.1, Q1.3 (C), R17.2
DATOS1V5: J13.4, R20.1
DATOS5V: J4.2, Q2.3 (C), R19.2
DOWN: J3.1, J7.2
EMER5V: J3.4, R8.1, U1.9
EMER24V: J8.3, J9.2, U1.7, U2.5, U2.7
ENB: J1.3, J11.3, U3.6 (-), U3.7
ENTER: J2.4, J6.1
ESC: J2.3, J6.2
FASEA: J1.5, J12.3
FASEB: J1.4, J12.4
FOTO5V: J3.5, R5.1, U1.15
FOTO24V: J9.1, J14.4, U1.1
GND: D1.1 (K), D2.1 (K), D3.1 (K), D4.1 (K), H1.1, H2.1, H3.1, H4.1, J0.1, J1.2, J5.1, J10.2, J12.2, J13.2, J14.3, Q1.1 (E), Q2.1 (E), R1.1, R2.1, R3.1, R4.1, R9.1, R10.1, R11.1, R12.1, R13.2, R14.2, R16.1, U3.4 (V-)
IN3: J4.3, J11.1, R13.1, U2.11, U2.15
IN4: J4.4, J11.2, R14.1, U2.9, U2.13
LR5V: J3.2, R6.1, U1.13
LR24V: J8.1, J9.4, U1.3
MICRO5V: J3.3, R7.1, U1.11, U3.5 (+)
MICRO24V: J8.2, J9.3, U1.5
unnamed: Q1.2 (B), R18.2
unnamed: Q2.2 (B), R20.2
unnamed: R1.2, U1.2
unnamed: R2.2, U1.4
unnamed: R3.2, U1.6
unnamed: R4.2, U1.8
unnamed: D1.2 (A), R5.2
unnamed: D2.2 (A), R6.2
unnamed: D3.2 (A), R7.2
unnamed: D4.2 (A), R8.2
unnamed: R9.2, U2.2
unnamed: R10.2, U2.4
unnamed: R11.2, U2.6
unnamed: R12.2, U2.8
unnamed: R15.1, R16.2, U3.3 (+)
RETROCESO: J7.4, J9.6, U2.3
SCL: J2.2, J6.4
SDA: J2.1, J6.3
UP: J2.5, J7.1

Notes on the sheet:
Conexiones Fotoeléctrico
Conexiones L298N
Conexiones Tapa
Amplificación de señales del calibre
Alimentación TL082
Buffer señal Micro
Alimentación Calibre
Optoacopladores
Alimentación sistema
Conexiones Calibre
Conexiones digitales
Conexiones Arduino
Agujeros de montaje
Conexiones Encoder

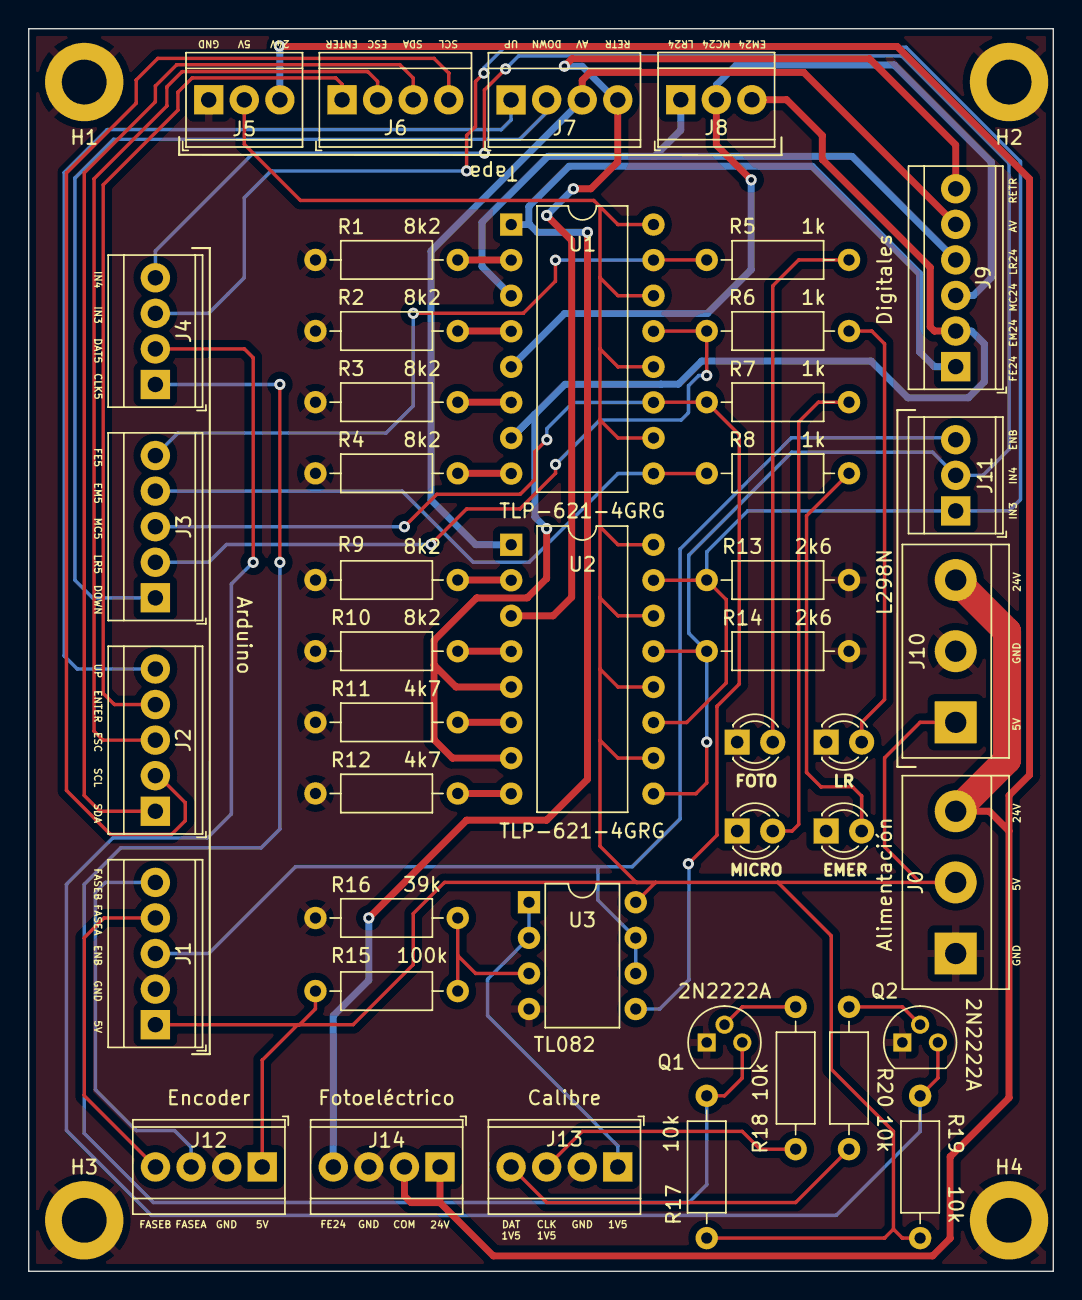
[picture p72: board fondo.kicad_pcb from above]

Board: 2 copper layers, 73.2 x 88.7 mm, 48 parts (0 on the bottom side), 44 nets.
