tonioprz/tfg/Placa/tapa/tapa.kicad_pcb

## KiCad design Placa/tapa/tapa.kicad_pcb (2022-02-23)

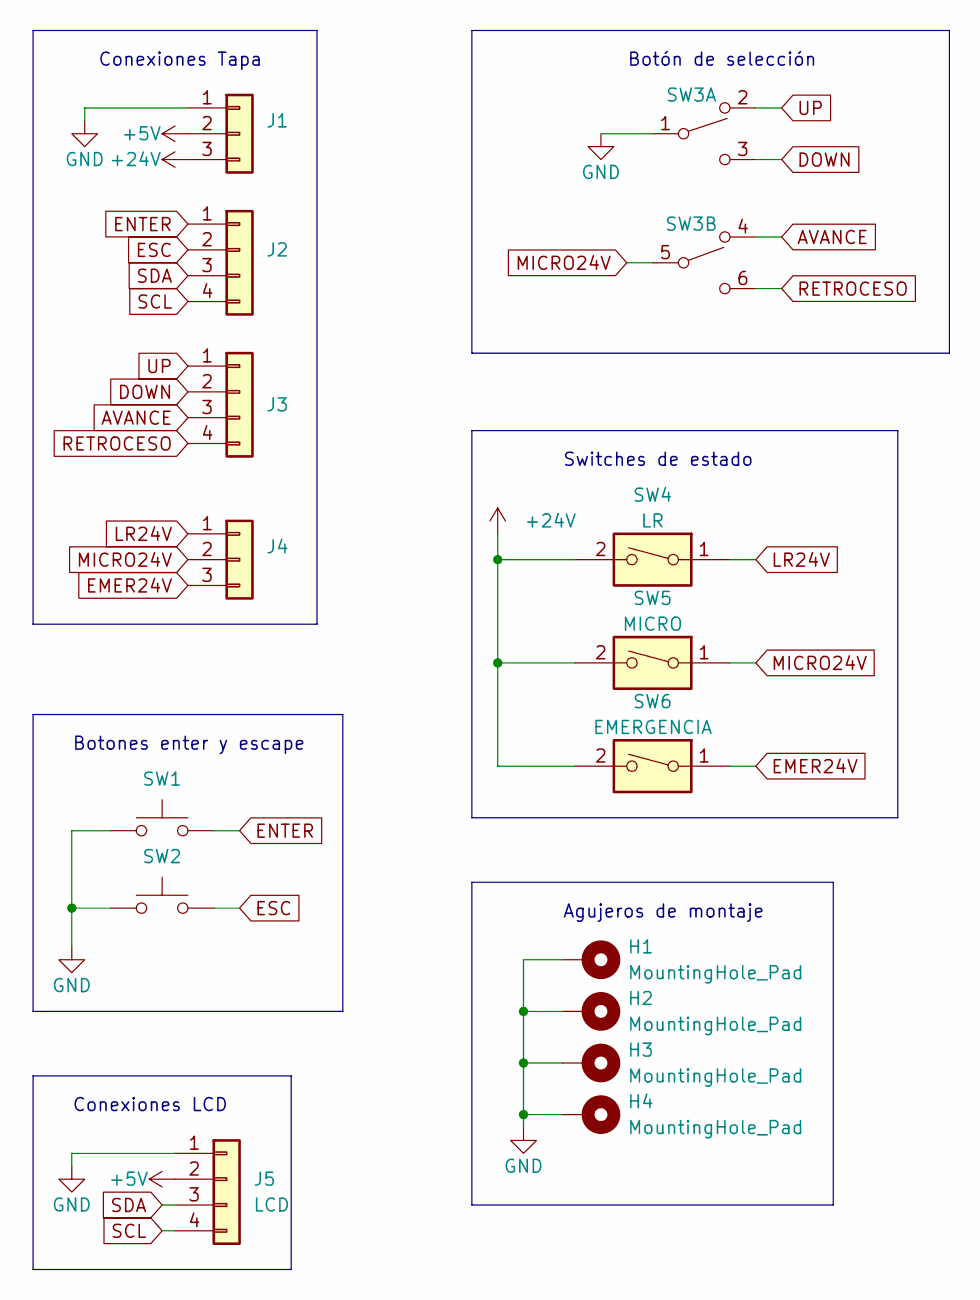
[picture p73: schematic tapa.kicad_sch]

Parts:
H1, H2, H3, H4: MountingHole_Pad; MountingHole_3.2mm_M3_DIN965_Pad
J1, J4: Conn_01x03; TerminalBlock_TE_282834-3_1x03_P2.54mm_Horizontal
J2, J3: Conn_01x04; TerminalBlock_TE_282834-4_1x04_P2.54mm_Horizontal
J5: LCD; TerminalBlock_TE_282834-4_1x04_P2.54mm_Horizontal
SW1: Enter; SW_PUSH_6mm_H8mm
SW2: ESC; SW_PUSH_6mm_H8mm
SW3: Botón Selección; TerminalBlock_TE_282834-6_1x06_P2.54mm_Horizontal
SW4: LR; TerminalBlock_TE_282834-2_1x02_P2.54mm_Horizontal
SW5: MICRO; TerminalBlock_TE_282834-2_1x02_P2.54mm_Horizontal
SW6: EMERGENCIA; TerminalBlock_TE_282834-2_1x02_P2.54mm_Horizontal

Connections:
+5V: J1.2, J5.2
+24V: J1.3, SW4.2, SW5.2, SW6.2
AVANCE: J3.3, SW3.4 (A)
DOWN: J3.2, SW3.3 (C)
EMER24V: J4.3, SW6.1
ENTER: J2.1, SW1.2
ESC: J2.2, SW2.2
GND: H1.1, H2.1, H3.1, H4.1, J1.1, J5.1, SW1.1, SW2.1, SW3.1 (B)
LR24V: J4.1, SW4.1
MICRO24V: J4.2, SW3.5 (B), SW5.1
RETROCESO: J3.4, SW3.6 (C)
SCL: J2.4, J5.4
SDA: J2.3, J5.3
UP: J3.1, SW3.2 (A)

Notes on the sheet:
Botones enter y escape
Botón de selección
Conexiones LCD
Agujeros de montaje
Conexiones Tapa
Switches de estado

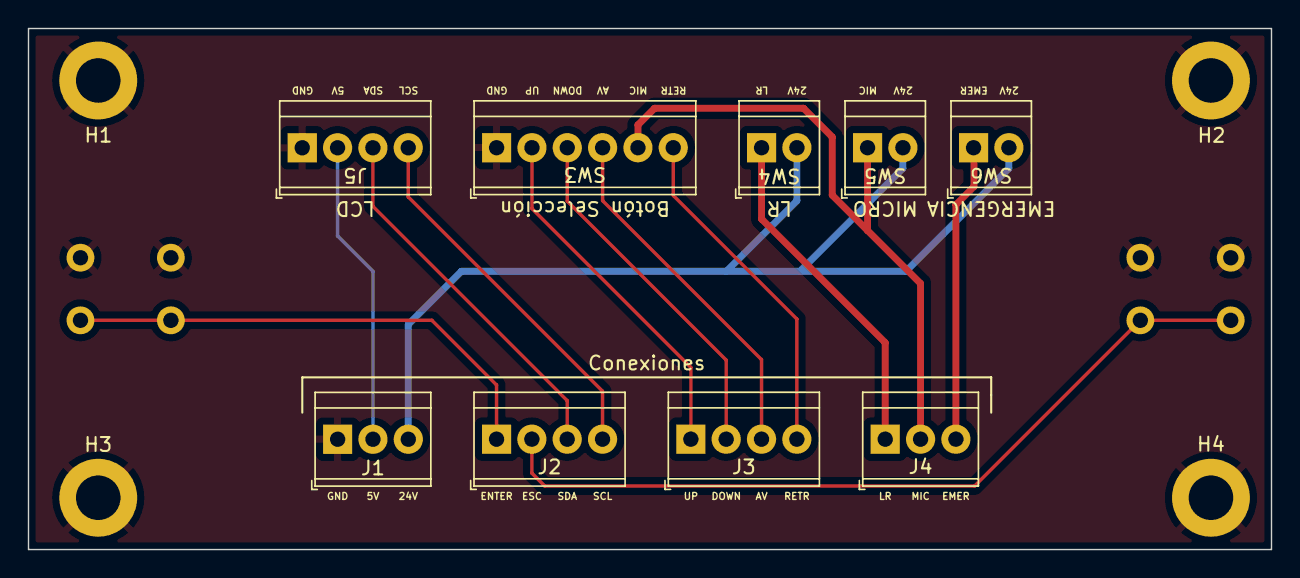
[picture p74: board tapa.kicad_pcb from above]

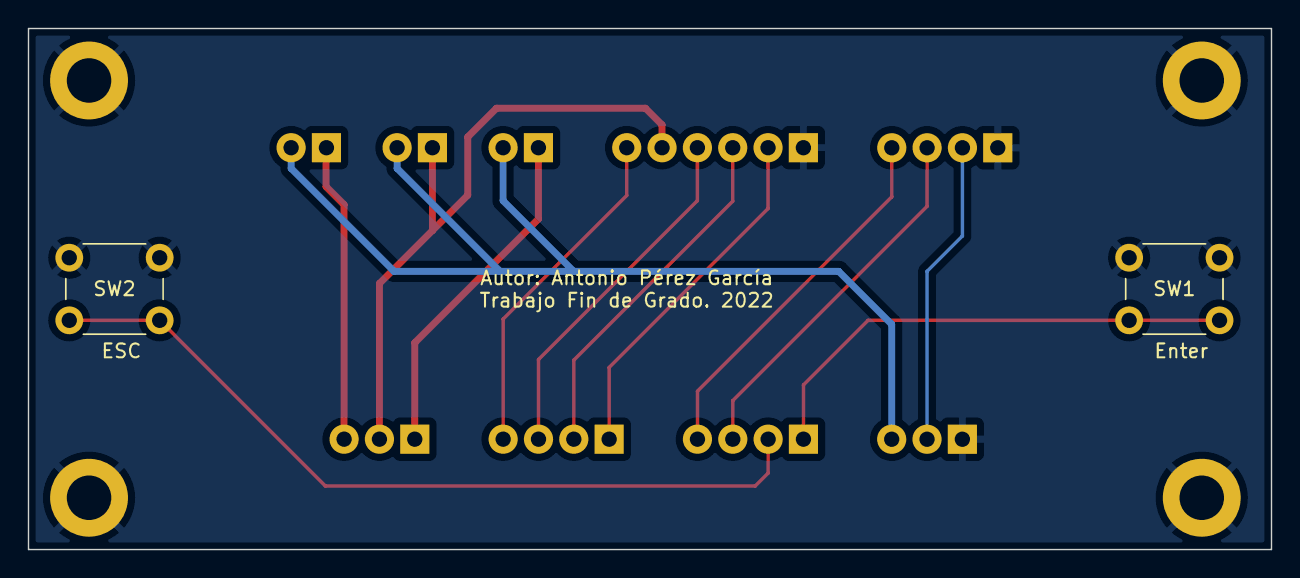
[picture p75: board tapa.kicad_pcb from below]

Board: 2 copper layers, 89.4 x 37.5 mm, 15 parts (2 on the bottom side), 14 nets.
