tonioprz/tfg/(commit log)

2020-12-21 Pruebas switch
2021-10-20 OUTPUT motor
2021-10-20 Interrupciones encoder
2021-10-23 Clase Motor
2021-10-24 Intento de Emergencia
2021-10-25 Emergencia en clase motor
2021-10-26 Actualizados valores a motor del laboratorio
2022-02-01 Case emergencia y sin micro
2022-02-15 Envio de datos a RobotStudio
    [EIO.cfg, MMC.cfg, MOC.cfg, PROC.cfg, SIO.cfg, SYS.cfg]
2022-02-15 Archivos .tex de cada apartado
2022-02-17 Corregido error signo en distancias largas
    [main.cpp]
2022-02-18 Esquemas kicad
    [EIO.cfg, MMC.cfg, MOC.cfg, PROC.cfg, SIO.cfg, SYS.cfg, fondo.kicad_pcb, fondo.kicad_sch]
2022-02-21 Diseño de placa
    [fondo-B_Cu.gbr, fondo-B_Mask.gbr, fondo-B_Paste.gbr, fondo-B_Silkscreen.gbr, fondo-Edge_Cuts.gbr, fondo-F_Cu.gbr, fondo-F_Mask.gbr, fondo-F_Paste.gbr]
2022-02-23 Finalización placas
    [fondo-B_Cu.gbr, fondo-B_Mask.gbr, fondo-B_Paste.gbr, fondo-B_Silkscreen.gbr, fondo-Edge_Cuts.gbr, fondo-F_Cu.gbr, fondo-F_Mask.gbr, fondo-F_Paste.gbr]
2022-02-23 Borrado archivos innecesarios RobotStudio
    [EIO.cfg, MMC.cfg, MOC.cfg, PROC.cfg, SIO.cfg, SYS.cfg]
2022-05-09 Hardware Arduino
2022-05-16 Conversión a Arduino IDE
2022-06-22 Comienzo código arduino
2022-06-24 codigo arduino y diagrama
2022-06-28 fin arduino
2022-07-06 creación guía de uso
2022-07-07 comienzo de guia de uso
2022-07-09 casi final ya
    [fondo.kicad_sch]
